ionutms/KiCad_Database_Library/3D_models/CUI_DEVICES_TBP04R2-500-10BE.step

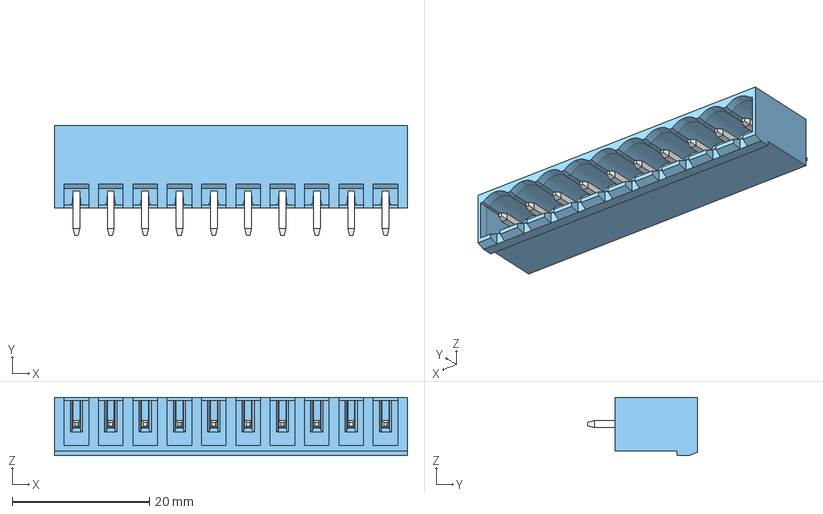
[picture p3: CAD file, 2024-11-04]
3D_models/CUI_DEVICES_TBP04R2-500-10BE.step
51.4 x 16.0 x 8.50 mm
