ionutms/KiCad_Database_Library/3D_models/CUI_DEVICES_TBP04R2-500-09BE.step

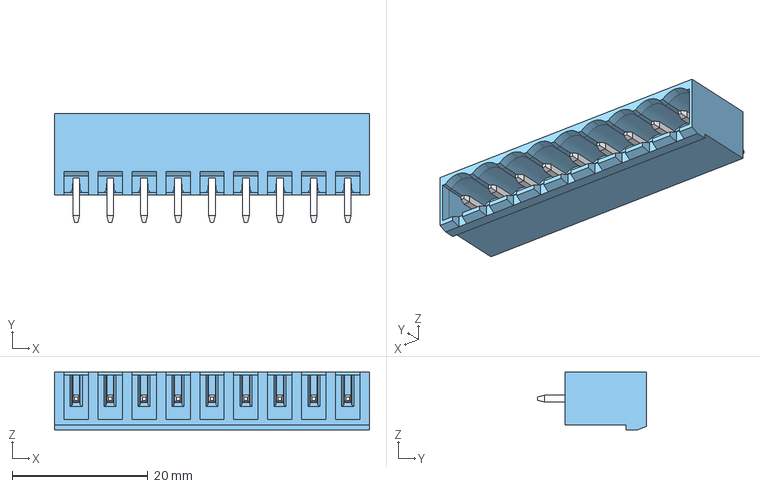
[picture p4: CAD file, 2024-11-04]
3D_models/CUI_DEVICES_TBP04R2-500-09BE.step
46.4 x 16.0 x 8.50 mm
