ionutms/KiCad_Database_Library/3D_models/CUI_DEVICES_TBP04R2-500-03BE.step

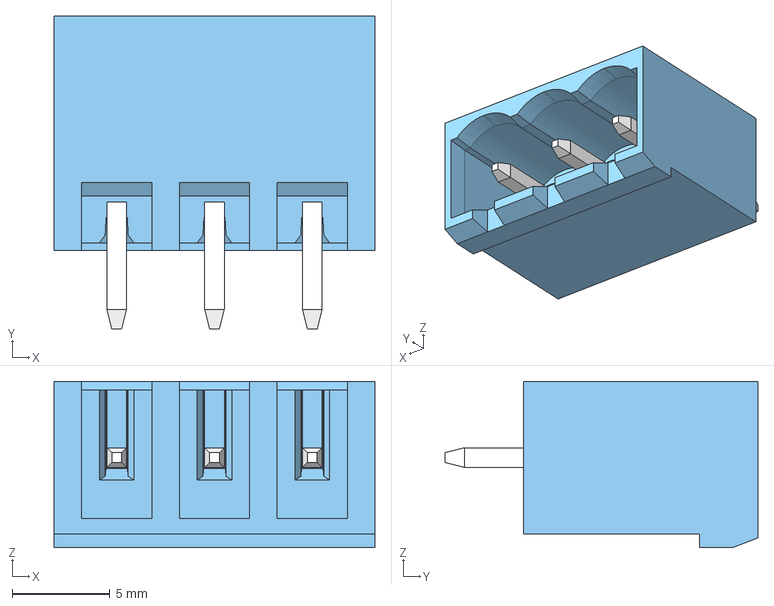
[picture p10: CAD file, 2024-11-04]
3D_models/CUI_DEVICES_TBP04R2-500-03BE.step
16.4 x 16.0 x 8.50 mm
