ionutms/KiCad_Database_Library/3D_models/CUI_DEVICES_TBP04R2-500-02BE.step

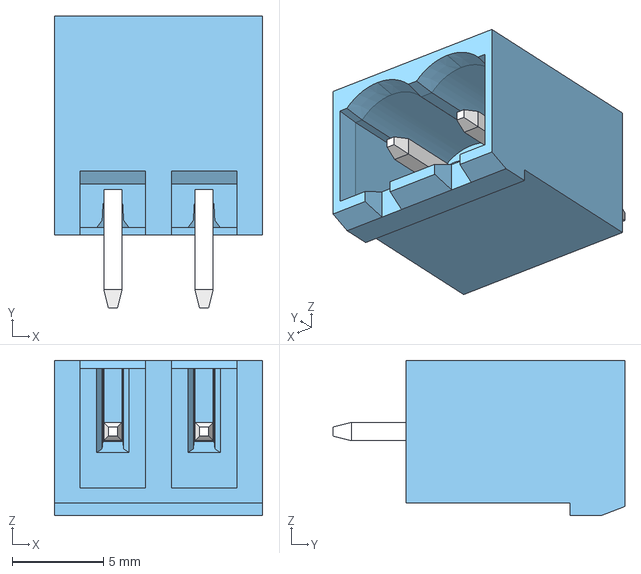
[picture p11: CAD file, 2024-11-04]
3D_models/CUI_DEVICES_TBP04R2-500-02BE.step
11.4 x 16.0 x 8.50 mm
