ionutms/KiCad_Database_Library/3D_models/CUI_DEVICES_TBP02R2-381-14BE.step

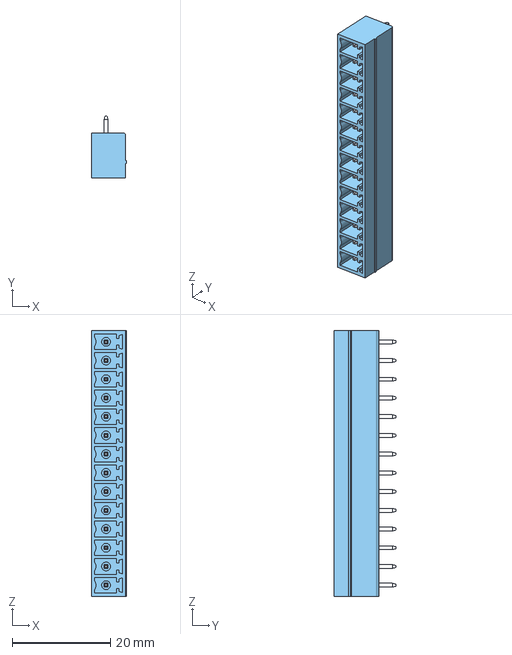
[picture p13: CAD file, 2024-11-04]
3D_models/CUI_DEVICES_TBP02R2-381-14BE.step
7.20 x 12.7 x 54.1 mm
