ionutms/KiCad_Database_Library/3D_models/CUI_DEVICES_TBP02R2-381-12BE.step

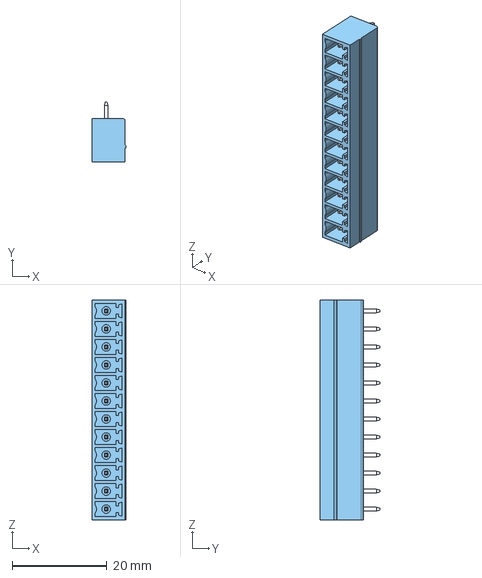
[picture p14: CAD file, 2024-11-04]
3D_models/CUI_DEVICES_TBP02R2-381-12BE.step
7.20 x 12.7 x 46.5 mm
