ionutms/KiCad_Database_Library/3D_models/CUI_DEVICES_TBP02R2-381-10BE.step

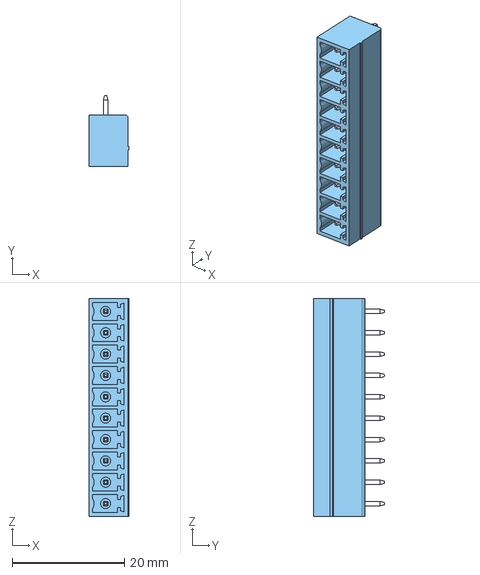
[picture p15: CAD file, 2024-11-04]
3D_models/CUI_DEVICES_TBP02R2-381-10BE.step
7.20 x 12.7 x 38.9 mm
