ionutms/KiCad_Database_Library/3D_models/CUI_DEVICES_TBP02R2-381-07BE.step

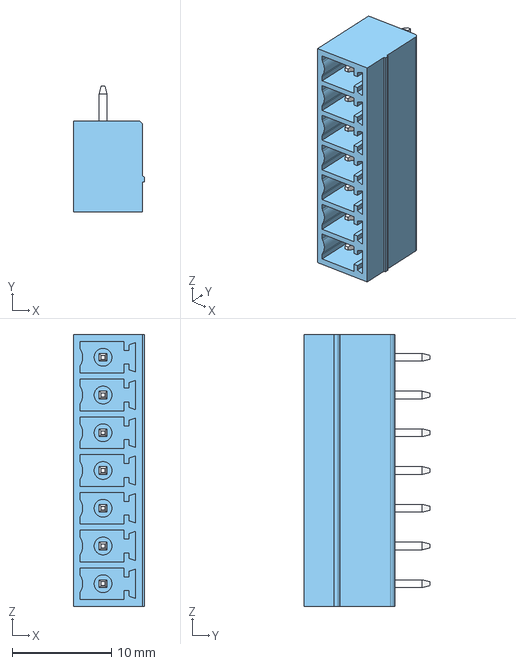
[picture p17: CAD file, 2024-11-03]
3D_models/CUI_DEVICES_TBP02R2-381-07BE.step
7.20 x 12.7 x 27.5 mm
