ionutms/KiCad_Database_Library/3D_models/CUI_DEVICES_TBP02R2-381-06BE.step

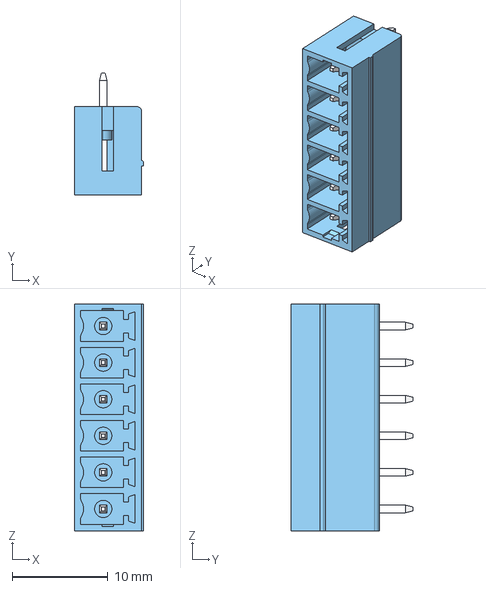
[picture p18: CAD file, 2024-11-03]
3D_models/CUI_DEVICES_TBP02R2-381-06BE.step
7.20 x 12.7 x 23.7 mm
