ionutms/KiCad_Database_Library/3D_models/CUI_DEVICES_TBP02R2-381-05BE.step

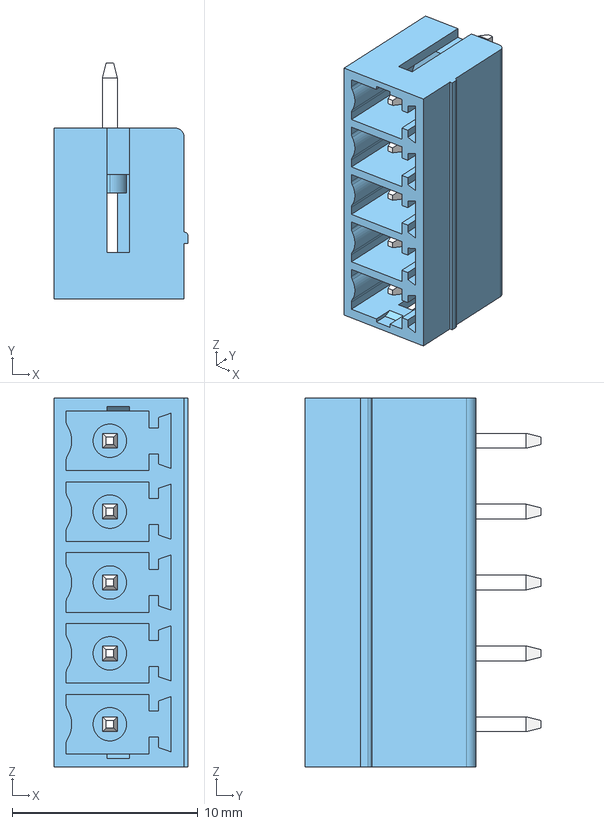
[picture p19: CAD file, 2024-11-03]
3D_models/CUI_DEVICES_TBP02R2-381-05BE.step
7.20 x 12.7 x 19.8 mm
