ionutms/KiCad_Database_Library/3D_models/CUI_DEVICES_TBP02R2-381-04BE.step

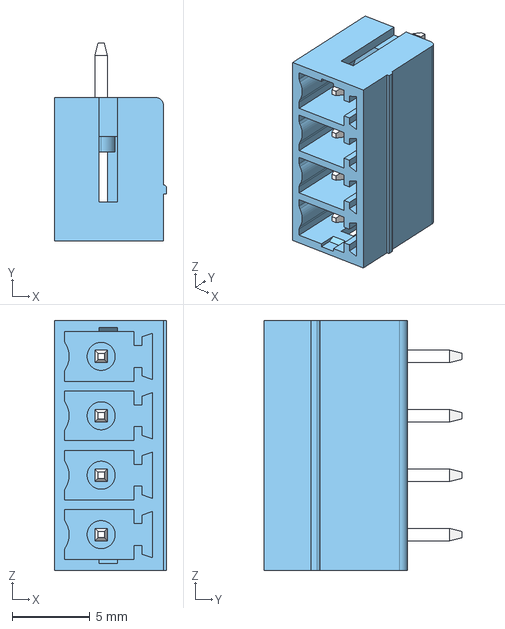
[picture p20: CAD file, 2024-11-03]
3D_models/CUI_DEVICES_TBP02R2-381-04BE.step
7.20 x 12.7 x 16.0 mm
