ionutms/KiCad_Database_Library/3D_models/XAL1580.step

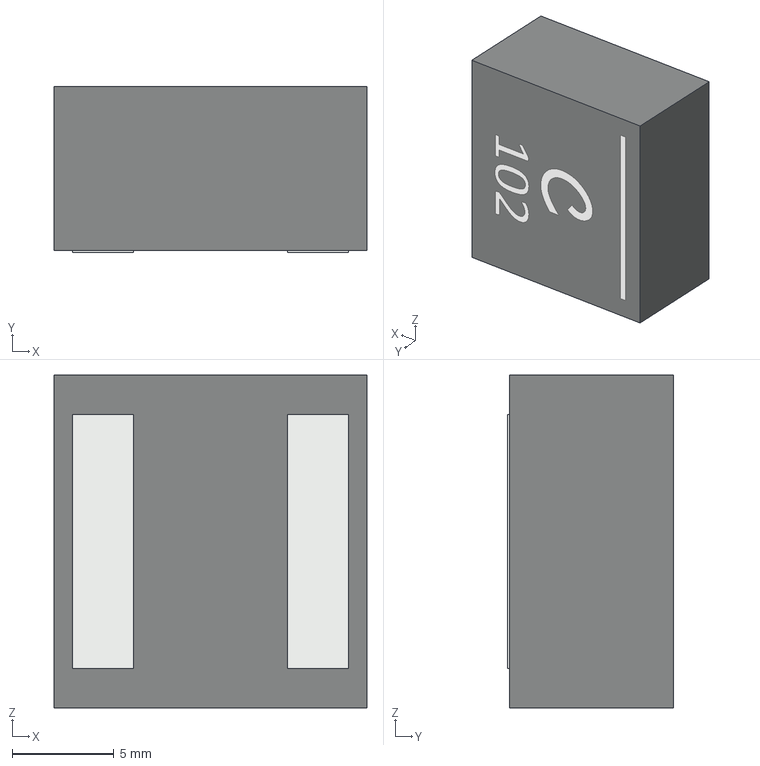
[picture p21: CAD file, 2024-11-01]
3D_models/XAL1580.step
15.4 x 8.20 x 16.4 mm
