ionutms/KiCad_Database_Library/3D_models/XAL1513.step

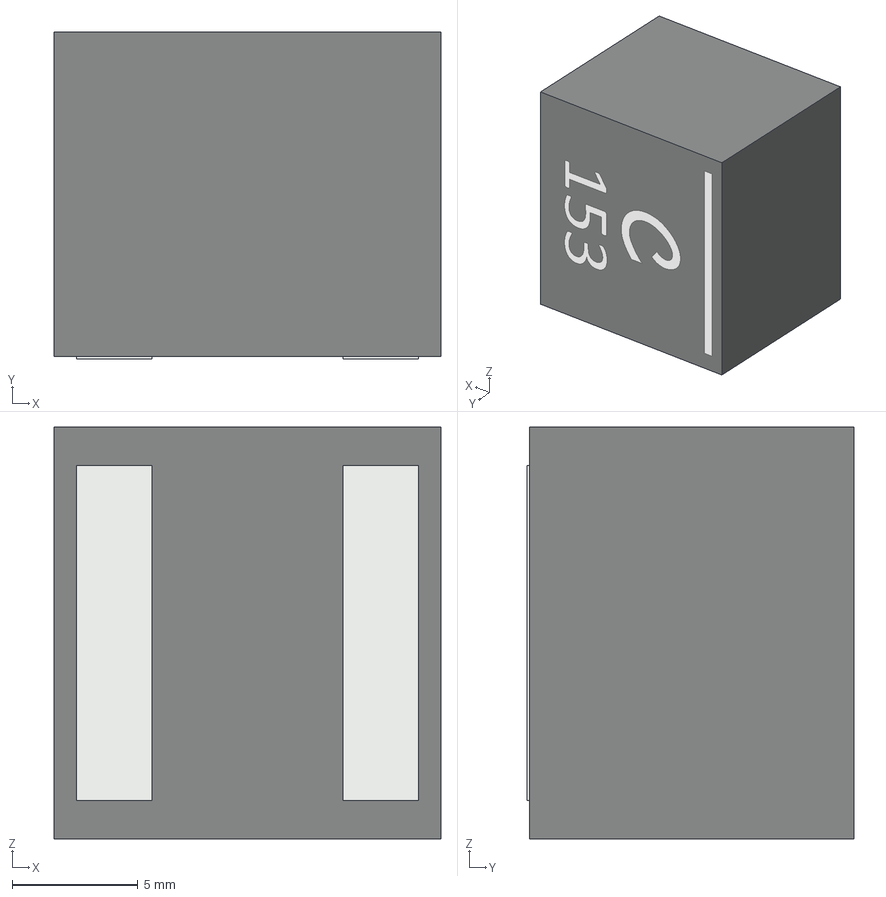
[picture p22: CAD file, 2024-11-01]
3D_models/XAL1513.step
15.4 x 13.0 x 16.4 mm
