ionutms/KiCad_Database_Library/3D_models/XAL1510.step

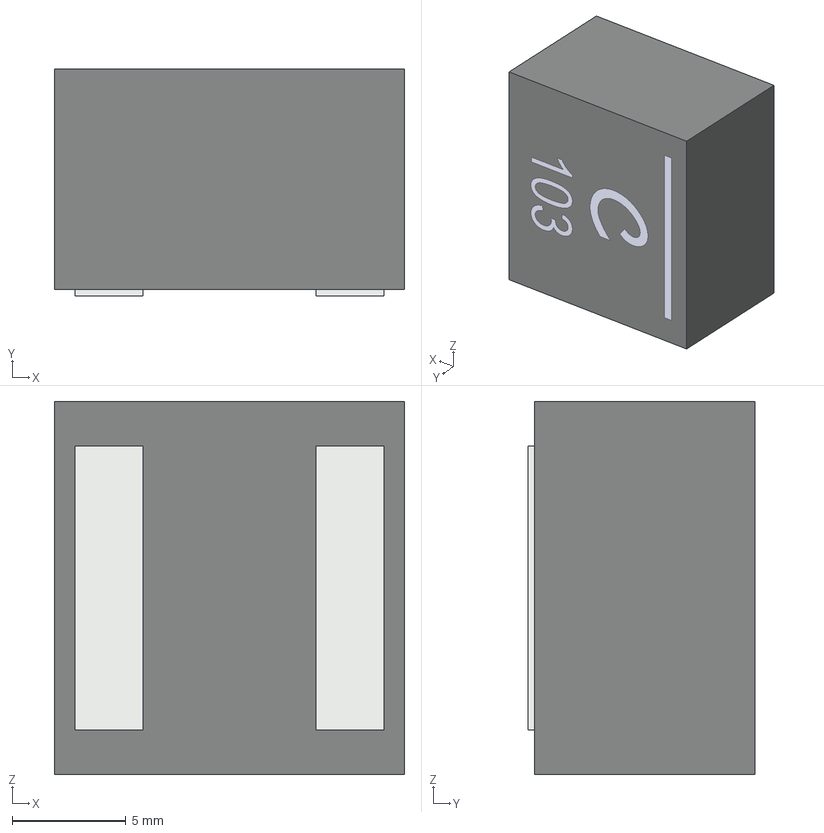
[picture p23: CAD file, 2024-11-01]
3D_models/XAL1510.step
15.4 x 10.0 x 16.4 mm
