ionutms/KiCad_Database_Library/3D_models/XAL1350.step

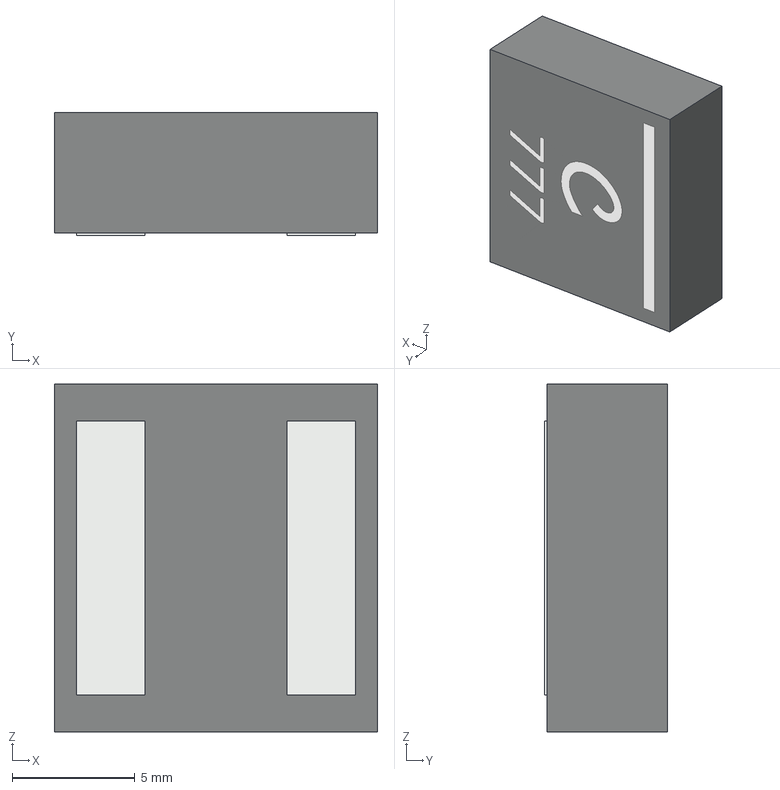
[picture p24: CAD file, 2024-11-01]
3D_models/XAL1350.step
13.2 x 5.00 x 14.2 mm
