ionutms/KiCad_Database_Library/3D_models/XAL1010.step

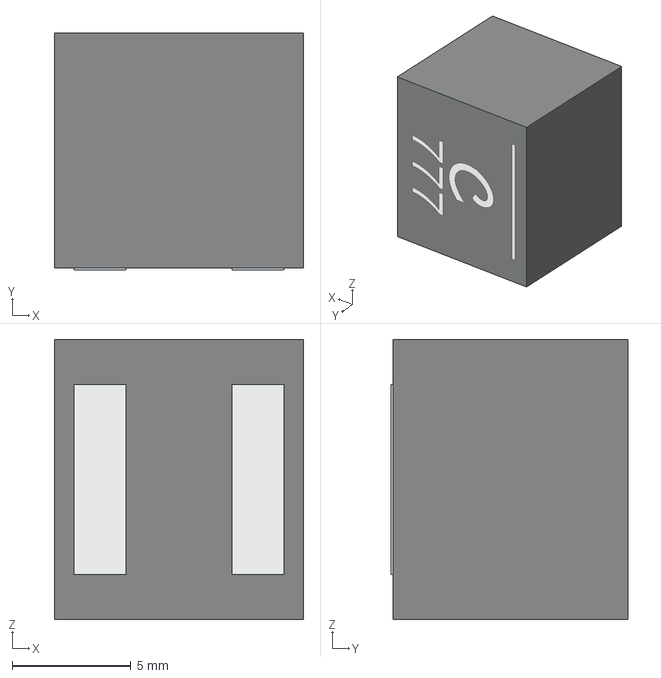
[picture p25: CAD file, 2024-11-01]
3D_models/XAL1010.step
10.5 x 10.0 x 11.8 mm
