ionutms/KiCad_Database_Library/3D_models/XAL8080.step

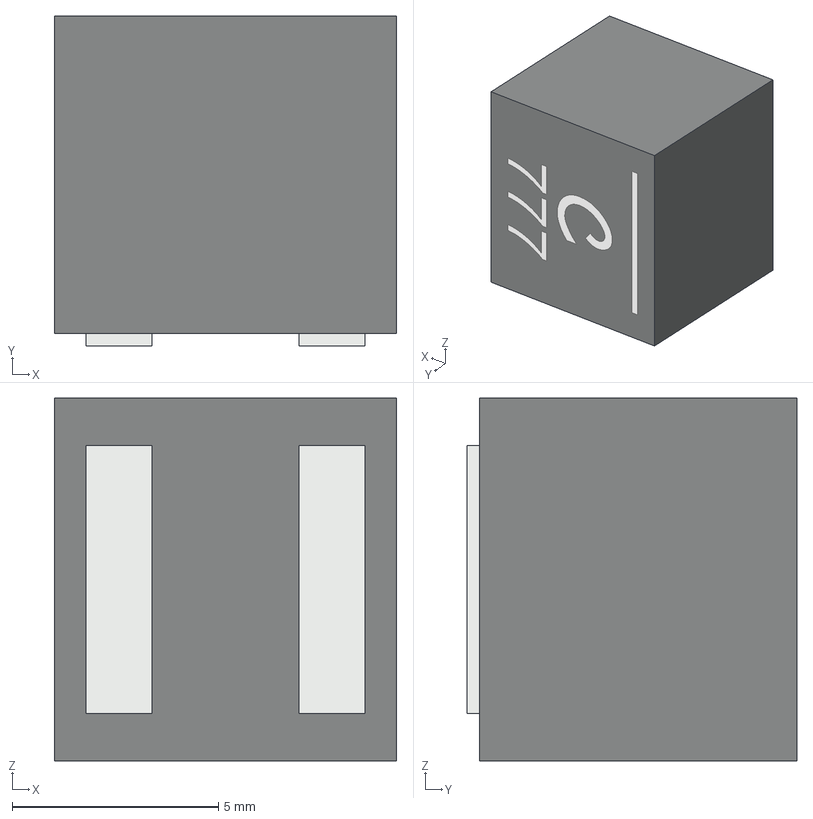
[picture p26: CAD file, 2024-10-31]
3D_models/XAL8080.step
8.30 x 8.00 x 8.80 mm
