ionutms/KiCad_Database_Library/3D_models/XAL8050.step

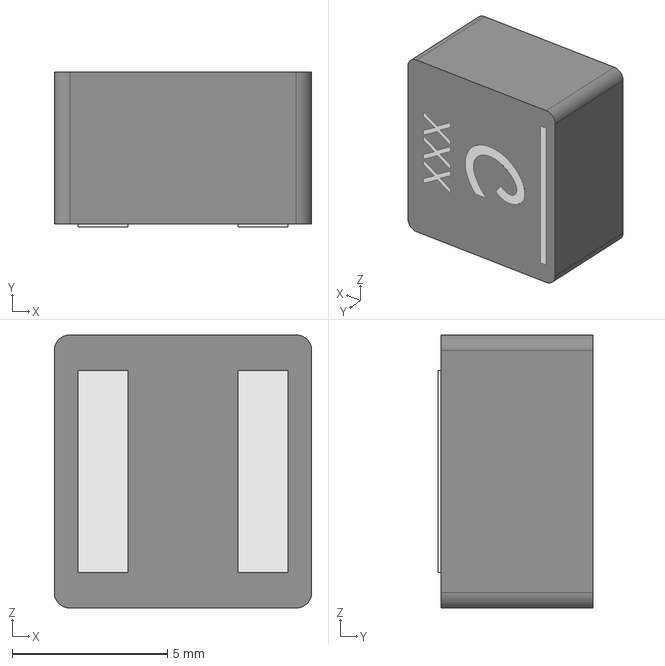
[picture p27: CAD file, 2024-10-31]
3D_models/XAL8050.step
8.30 x 5.00 x 8.80 mm
