ionutms/KiCad_Database_Library/3D_models/XAL7070.step

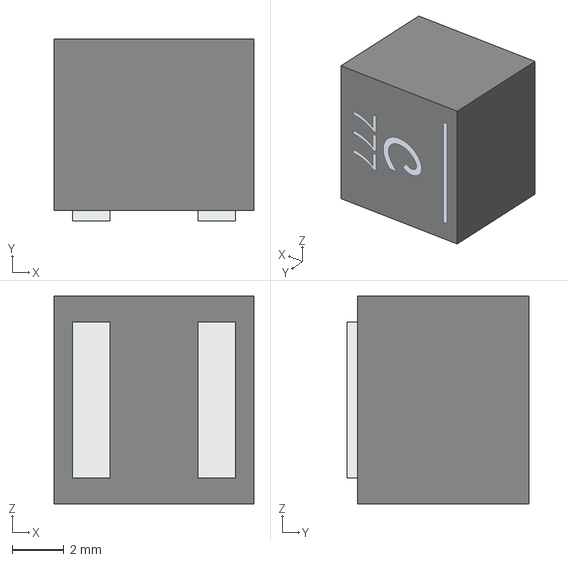
[picture p28: CAD file, 2024-10-31]
3D_models/XAL7070.step
7.70 x 7.00 x 8.00 mm
