ionutms/KiCad_Database_Library/3D_models/XAL7050.step

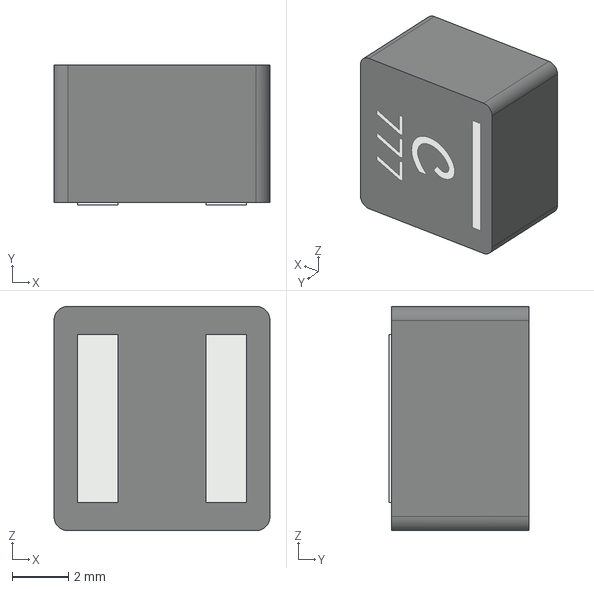
[picture p29: CAD file, 2024-10-31]
3D_models/XAL7050.step
7.70 x 5.00 x 8.00 mm
