ionutms/KiCad_Database_Library/3D_models/XAL7030.step

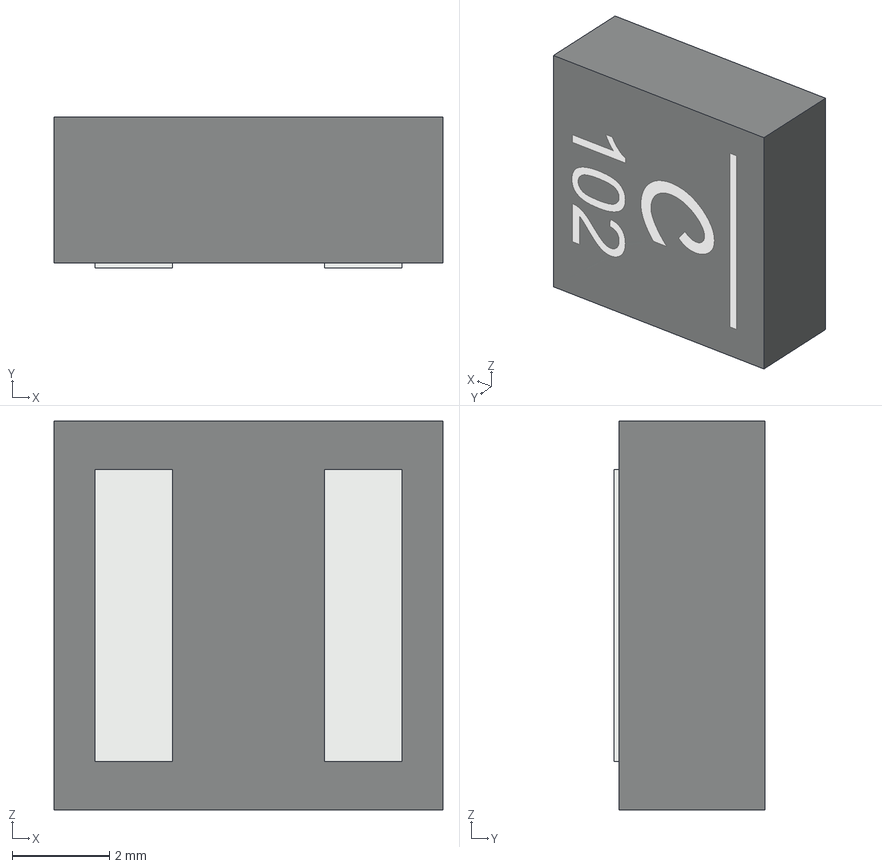
[picture p30: CAD file, 2024-10-31]
3D_models/XAL7030.step
8.00 x 3.10 x 8.00 mm
