ionutms/KiCad_Database_Library/3D_models/XAL1080.step

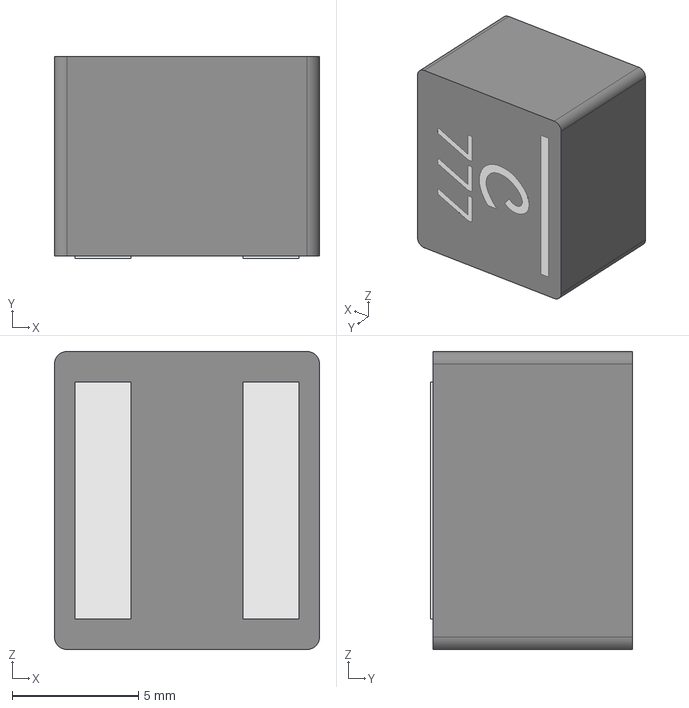
[picture p31: CAD file, 2024-10-31]
3D_models/XAL1080.step
10.5 x 8.00 x 11.8 mm
