ionutms/KiCad_Database_Library/3D_models/XAL1060.step

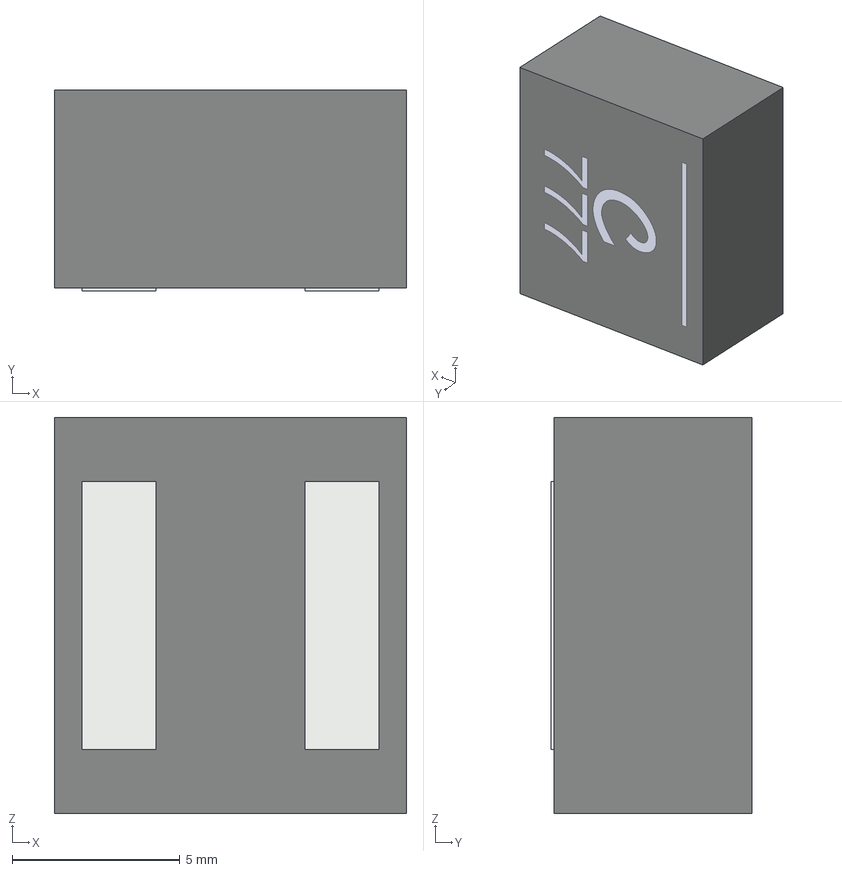
[picture p32: CAD file, 2024-10-31]
3D_models/XAL1060.step
10.5 x 6.00 x 11.8 mm
