ionutms/KiCad_Database_Library/3D_models/XAL1030.step

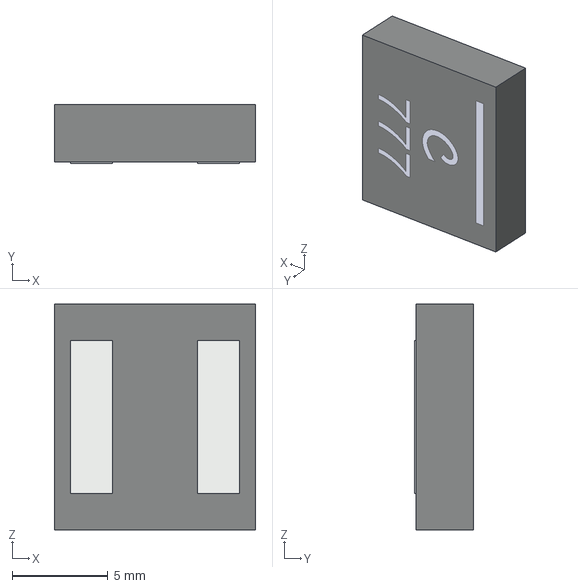
[picture p33: CAD file, 2024-10-31]
3D_models/XAL1030.step
10.5 x 3.10 x 11.8 mm
