ionutms/KiCad_Database_Library/3D_models/XAL7020.step

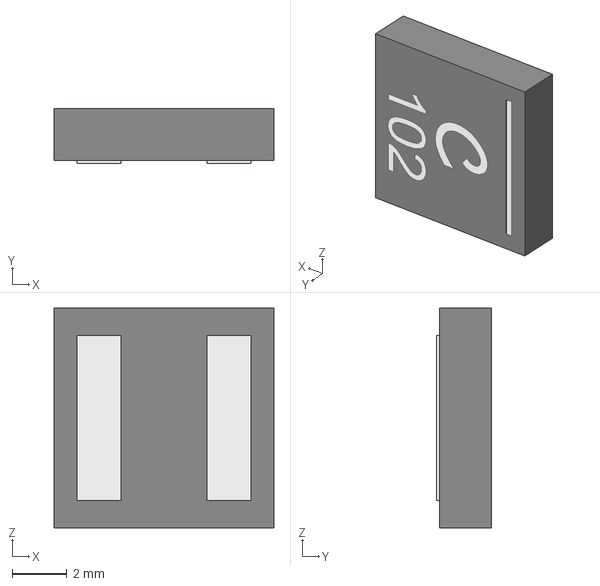
[picture p34: CAD file, 2024-10-30]
3D_models/XAL7020.step
8.00 x 2.00 x 8.00 mm
