ionutms/KiCad_Database_Library/3D_models/XAL6060.step

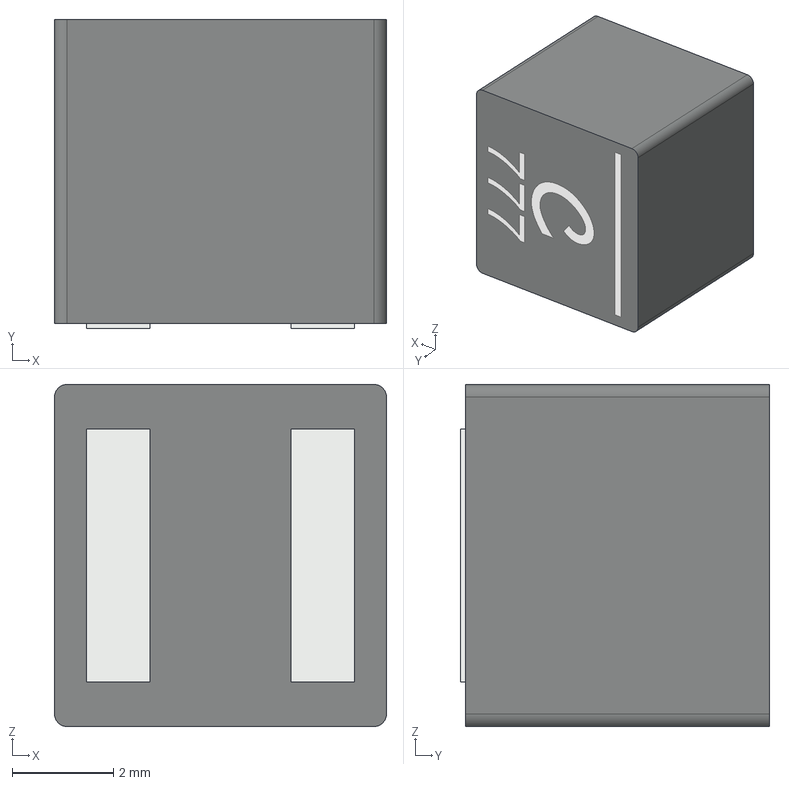
[picture p35: CAD file, 2024-10-30]
3D_models/XAL6060.step
6.56 x 6.10 x 6.76 mm
