ionutms/KiCad_Database_Library/3D_models/XAL6030.step

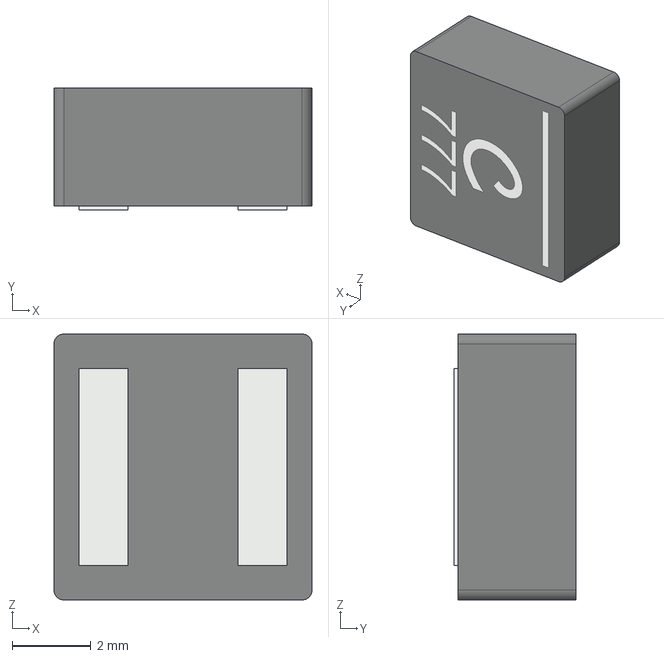
[picture p36: CAD file, 2024-10-30]
3D_models/XAL6030.step
6.56 x 3.10 x 6.76 mm
