ionutms/KiCad_Database_Library/3D_models/XAL6020.step

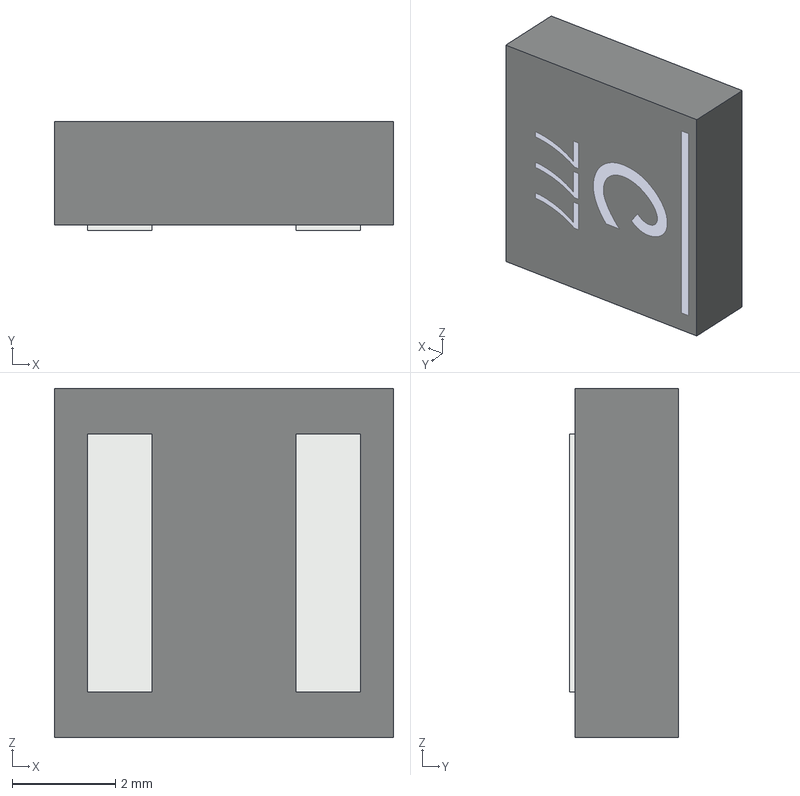
[picture p37: CAD file, 2024-10-30]
3D_models/XAL6020.step
6.56 x 2.10 x 6.76 mm
