ionutms/KiCad_Database_Library/3D_models/XAL5050.step

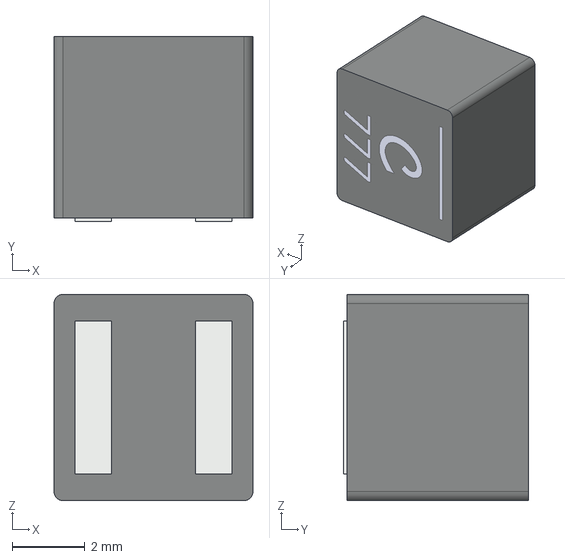
[picture p38: CAD file, 2024-10-30]
3D_models/XAL5050.step
5.48 x 5.10 x 5.68 mm
