ionutms/KiCad_Database_Library/3D_models/XAL5030.step

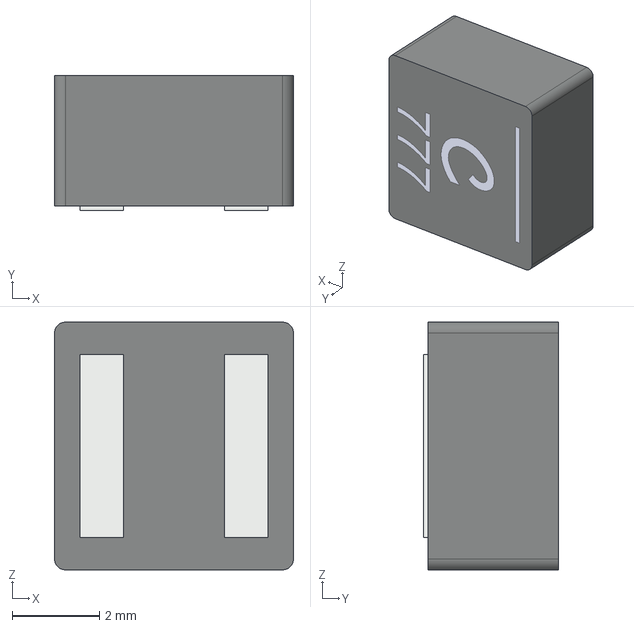
[picture p39: CAD file, 2024-10-30]
3D_models/XAL5030.step
5.48 x 3.10 x 5.68 mm
