ionutms/KiCad_Database_Library/3D_models/XAL5020.step

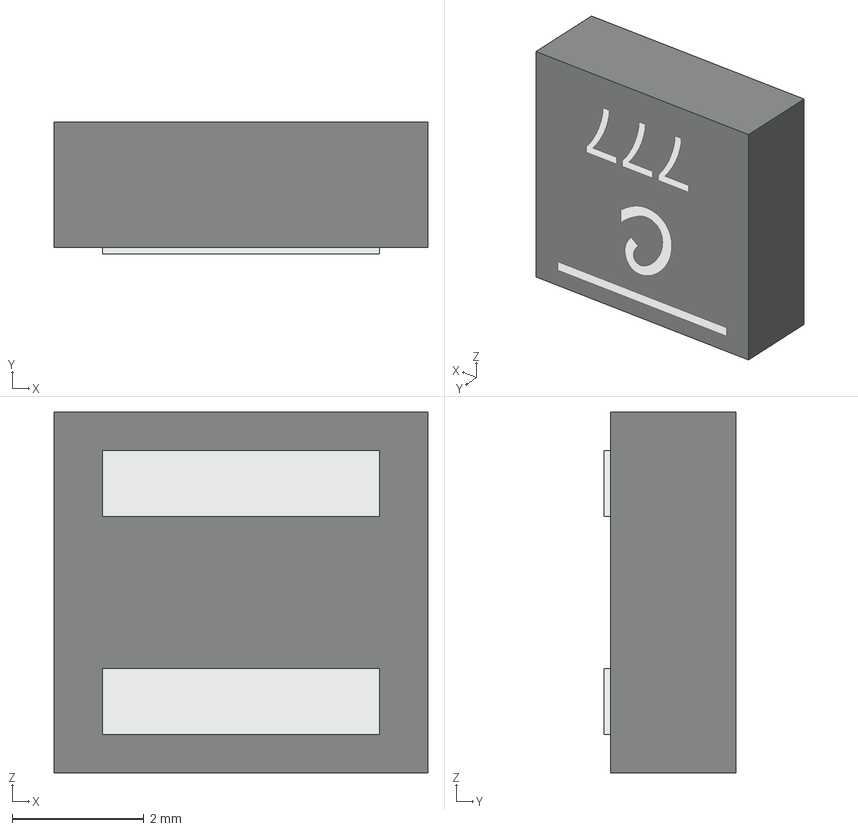
[picture p40: CAD file, 2024-10-30]
3D_models/XAL5020.step
5.68 x 2.00 x 5.48 mm
