ionutms/KiCad_Database_Library/3D_models/XAL4040.step

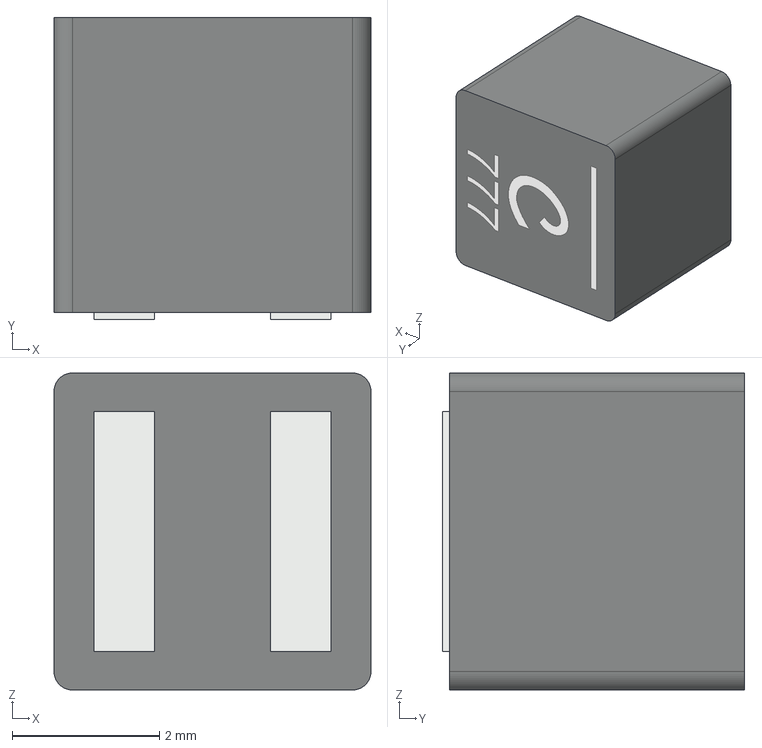
[picture p41: CAD file, 2024-10-30]
3D_models/XAL4040.step
4.30 x 4.10 x 4.30 mm
