ionutms/KiCad_Database_Library/3D_models/XAL4030.step

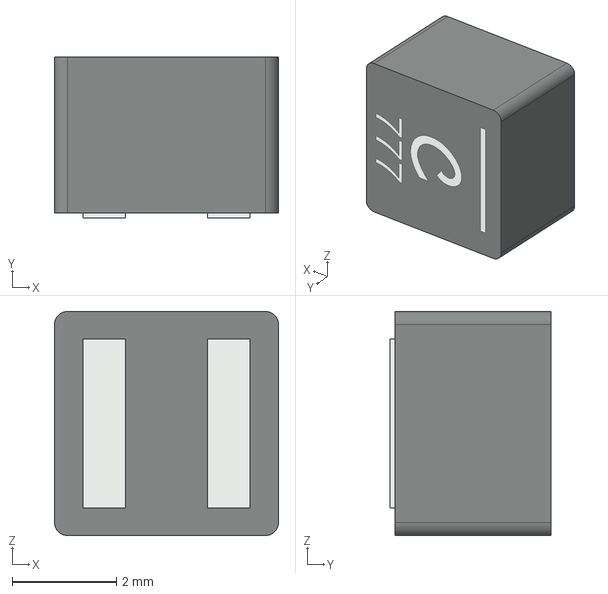
[picture p42: CAD file, 2024-10-30]
3D_models/XAL4030.step
4.30 x 3.10 x 4.30 mm
