ionutms/KiCad_Database_Library/3D_models/XAL4020.step

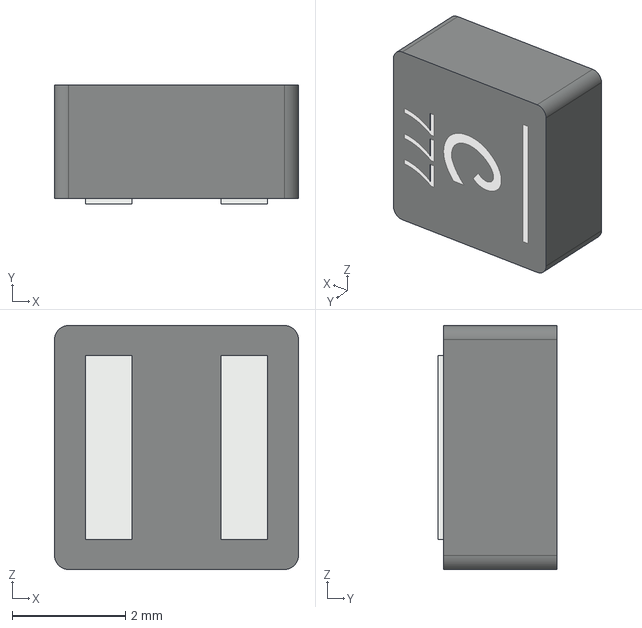
[picture p43: CAD file, 2024-10-30]
3D_models/XAL4020.step
4.30 x 2.10 x 4.30 mm
