ionutms/KiCad_Database_Library/3D_models/XFL2005.step

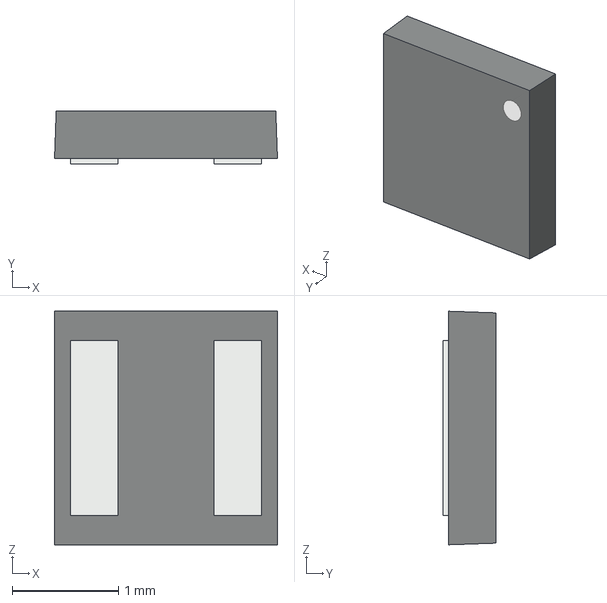
[picture p44: CAD file, 2024-10-30]
3D_models/XFL2005.step
2.10 x 0.5 x 2.20 mm
