ionutms/KiCad_Database_Library/3D_models/XFL2006.step

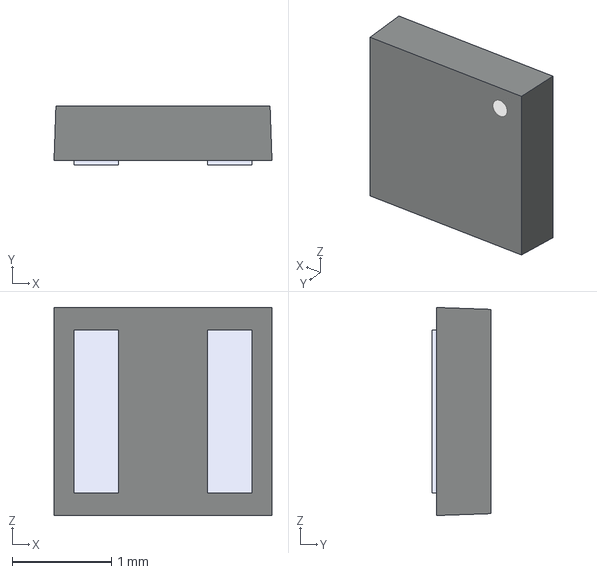
[picture p45: CAD file, 2024-10-30]
3D_models/XFL2006.step
2.20 x 0.6 x 2.10 mm
