ionutms/KiCad_Database_Library/3D_models/XFL2010.step

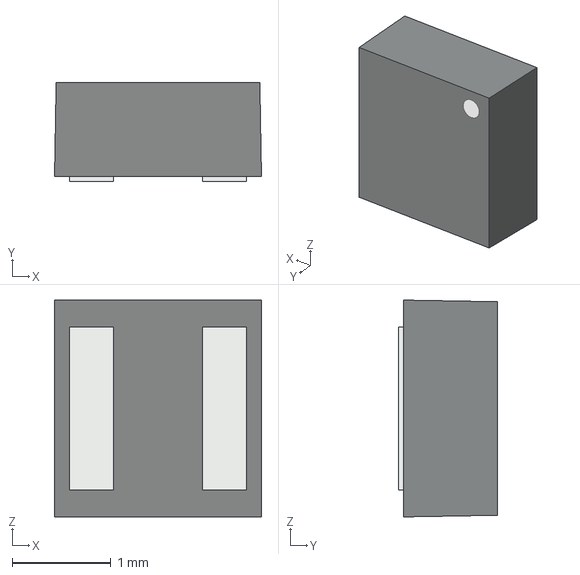
[picture p46: CAD file, 2024-10-30]
3D_models/XFL2010.step
2.10 x 1.00 x 2.20 mm
