ionutms/KiCad_Database_Library/3D_models/XFL7015.step

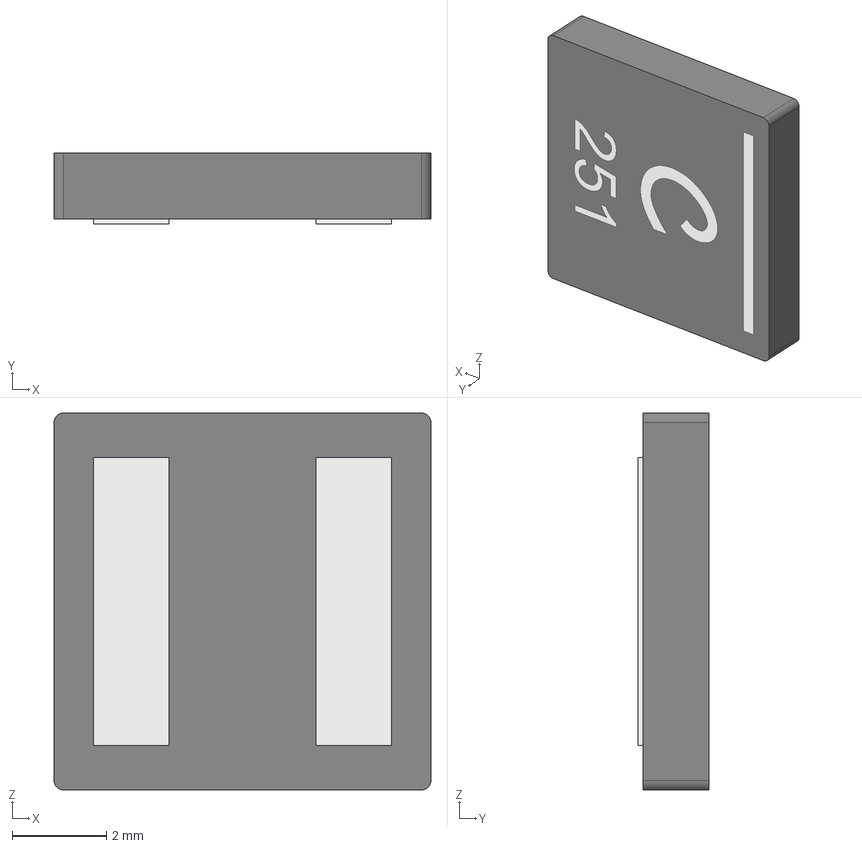
[picture p47: CAD file, 2024-10-28]
3D_models/XFL7015.step
8.00 x 1.50 x 8.00 mm
