ionutms/KiCad_Database_Library/3D_models/XFL6012.step

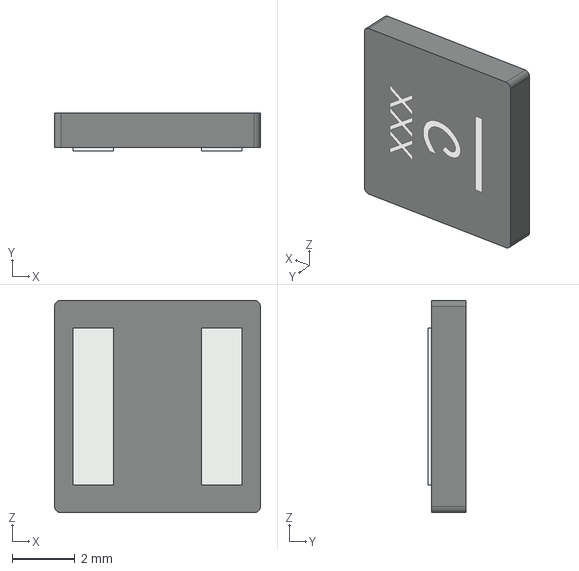
[picture p48: CAD file, 2024-10-28]
3D_models/XFL6012.step
6.56 x 1.20 x 6.76 mm
