ionutms/KiCad_Database_Library/3D_models/XFL5018.step

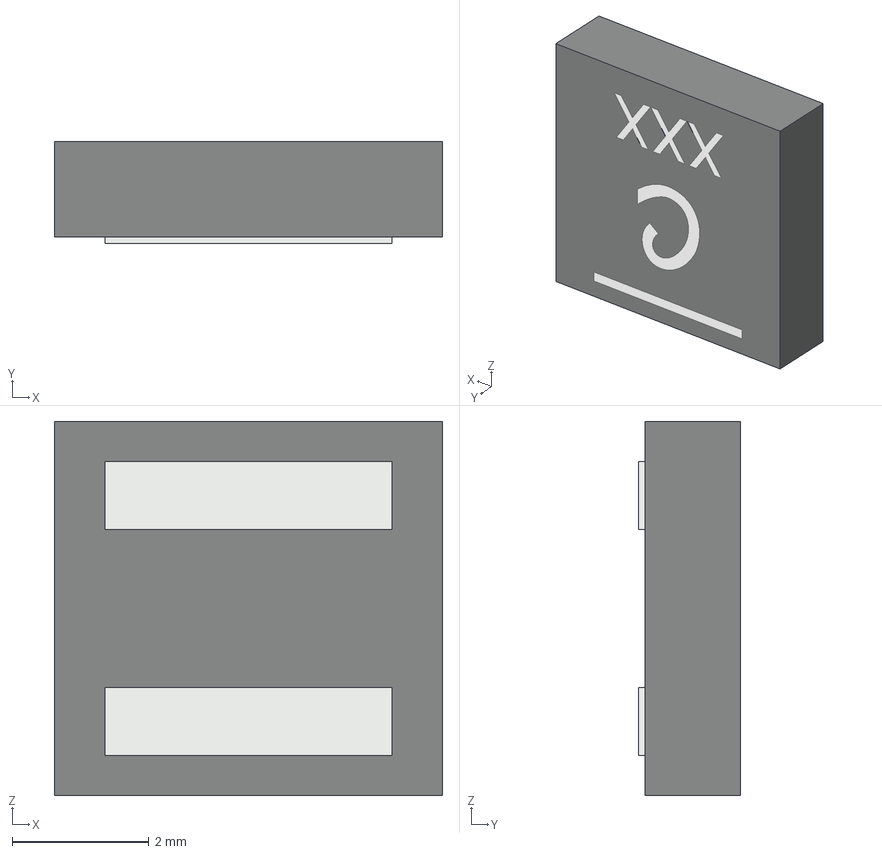
[picture p49: CAD file, 2024-10-28]
3D_models/XFL5018.step
5.68 x 1.50 x 5.48 mm
