ionutms/KiCad_Database_Library/3D_models/XFL4015.step

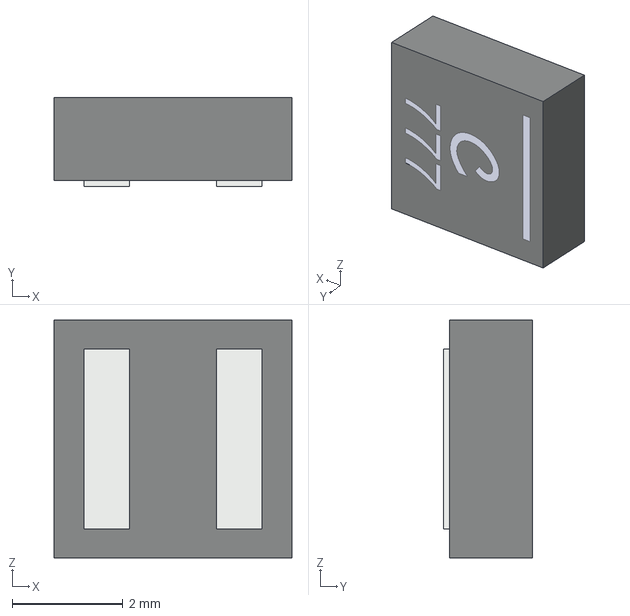
[picture p50: CAD file, 2024-10-28]
3D_models/XFL4015.step
4.30 x 1.60 x 4.30 mm
