ionutms/KiCad_Database_Library/3D_models/XFL4012.step

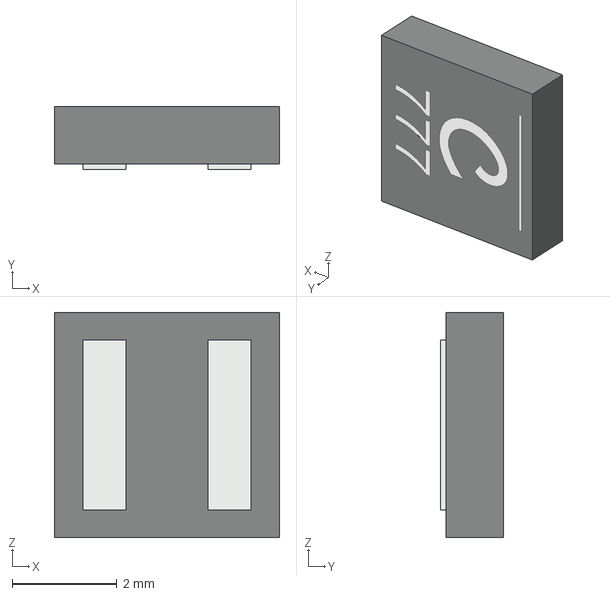
[picture p51: CAD file, 2024-10-28]
3D_models/XFL4012.step
4.30 x 1.20 x 4.30 mm
