ionutms/KiCad_Database_Library/3D_models/XFL3012.step

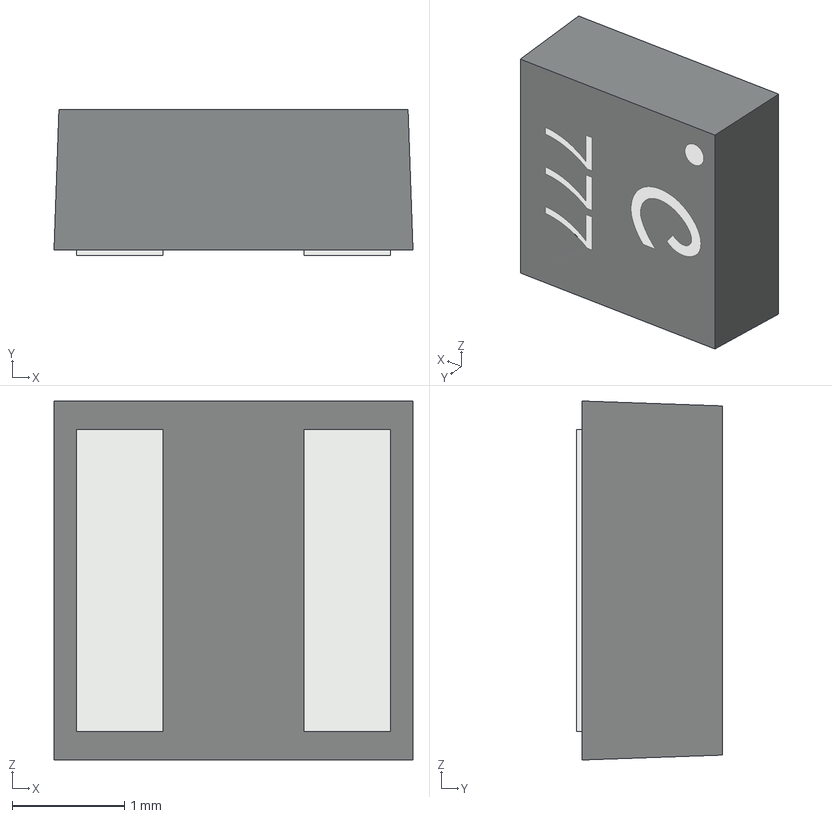
[picture p52: CAD file, 2024-10-28]
3D_models/XFL3012.step
3.20 x 1.30 x 3.20 mm
