ionutms/KiCad_Database_Library/3D_models/XFL3010.step

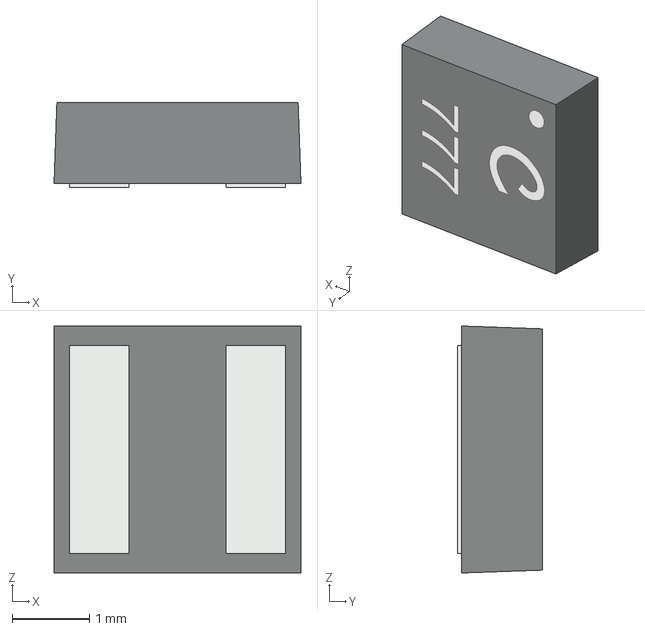
[picture p53: CAD file, 2024-10-28]
3D_models/XFL3010.step
3.20 x 1.10 x 3.20 mm
