ionutms/KiCad_Database_Library/3D_models/R_1206.step

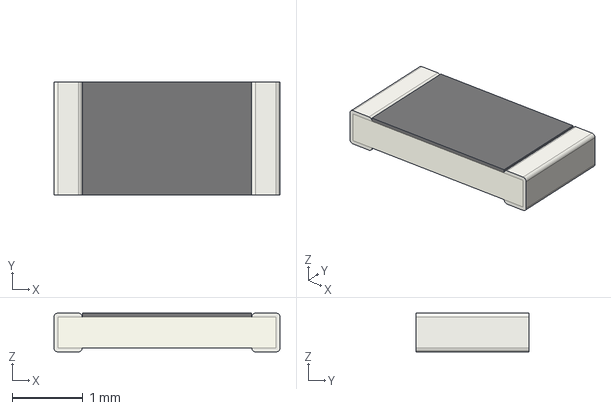
[picture p54: CAD file, 2024-10-23]
3D_models/R_1206.step
3.20 x 1.60 x 0.55 mm
