ionutms/KiCad_Database_Library/3D_models/SMCJ40CA.step

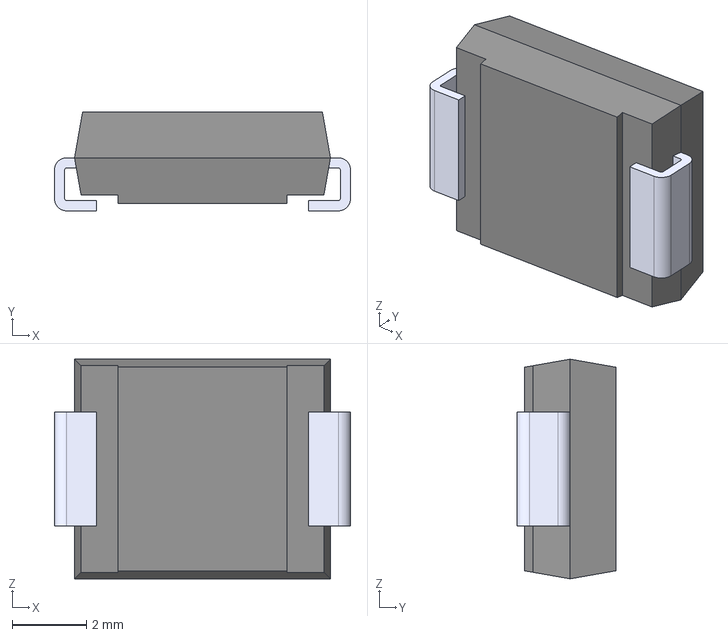
[picture p55: CAD file, 2024-10-07]
3D_models/SMCJ40CA.step
7.95 x 2.65 x 5.90 mm
