ionutms/KiCad_Database_Library/3D_models/SC-70.step

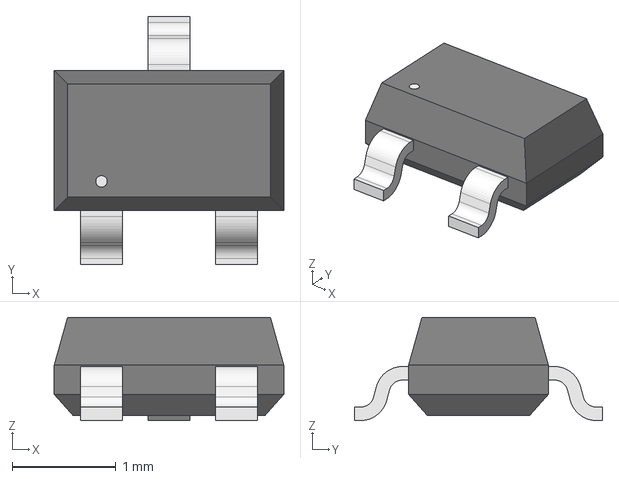
[picture p56: CAD file, 2024-10-05]
3D_models/SC-70.step
2.21 x 2.39 x 0.993 mm
