ionutms/KiCad_Database_Library/3D_models/SOT-26.step

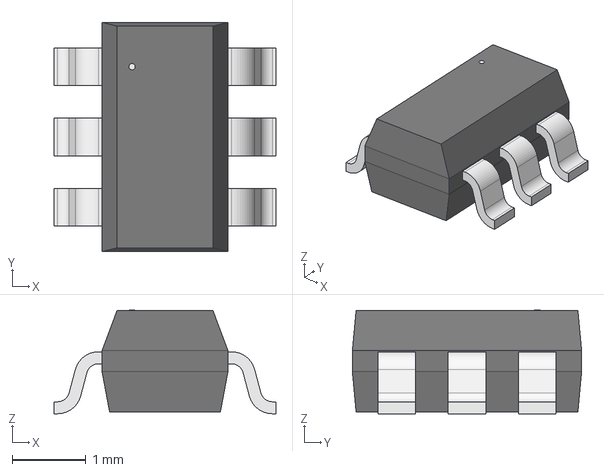
[picture p57: CAD file, 2024-10-05]
3D_models/SOT-26.step
3.00 x 3.10 x 1.40 mm
