ionutms/KiCad_Database_Library/3D_models/L_0402.step

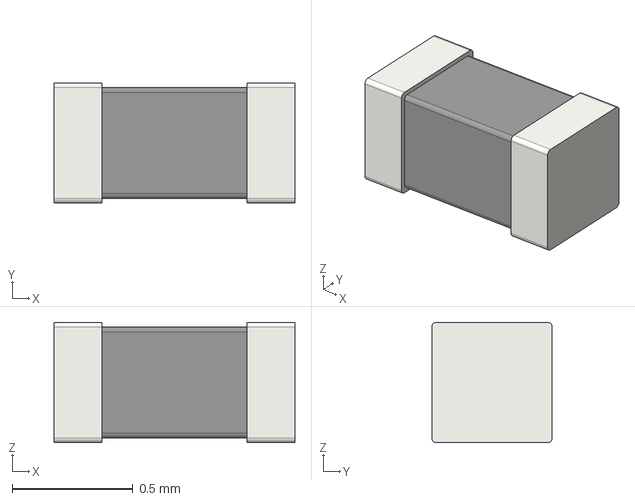
[picture p58: CAD file, 2024-10-05]
3D_models/L_0402.step
1.00 x 0.5 x 0.5 mm
