ionutms/KiCad_Database_Library/3D_models/R_2010.step

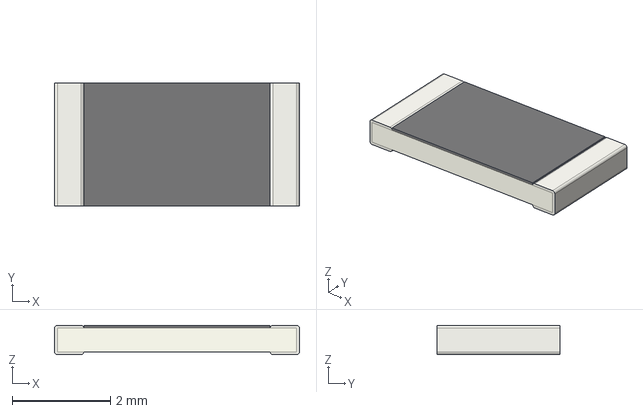
[picture p59: CAD file, 2024-10-05]
3D_models/R_2010.step
5.00 x 2.50 x 0.6 mm
