ionutms/KiCad_Database_Library/3D_models/C_1812.step

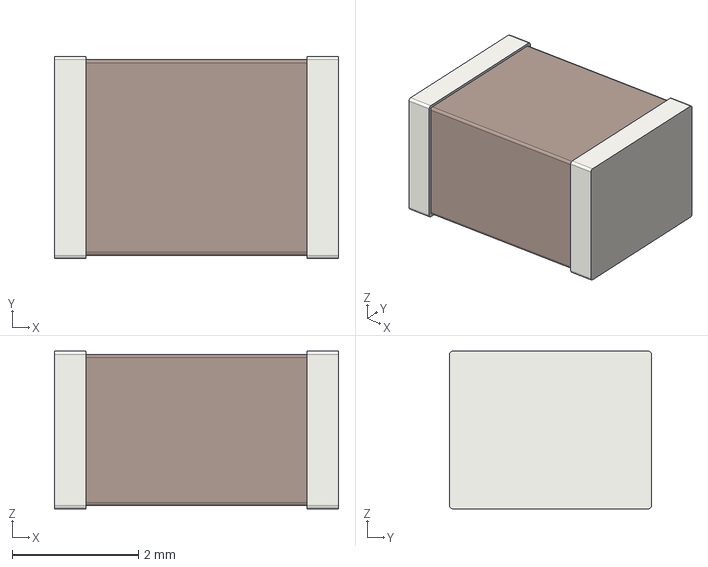
[picture p60: CAD file, 2024-10-05]
3D_models/C_1812.step
4.50 x 3.20 x 2.50 mm
