ionutms/KiCad_Database_Library/3D_models/SOT-323.step

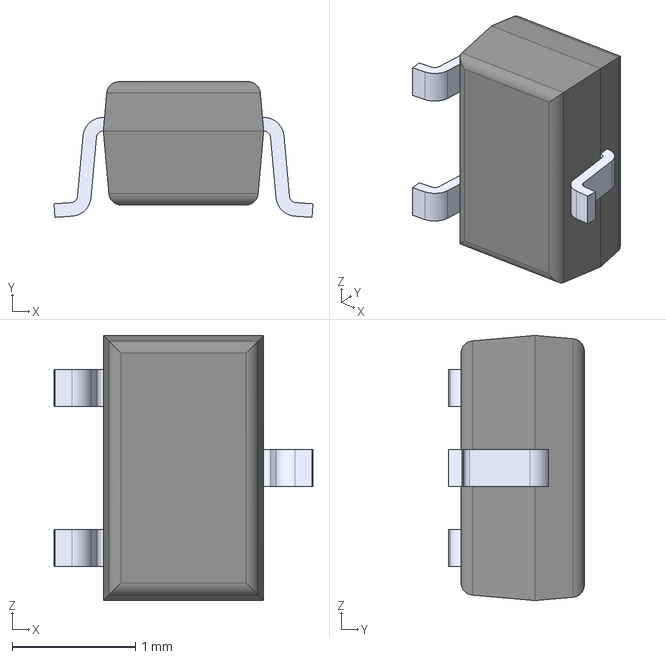
[picture p61: CAD file, 2024-10-04]
3D_models/SOT-323.step
2.10 x 1.10 x 2.15 mm
