ionutms/KiCad_Database_Library/3D_models/SOT1205.step

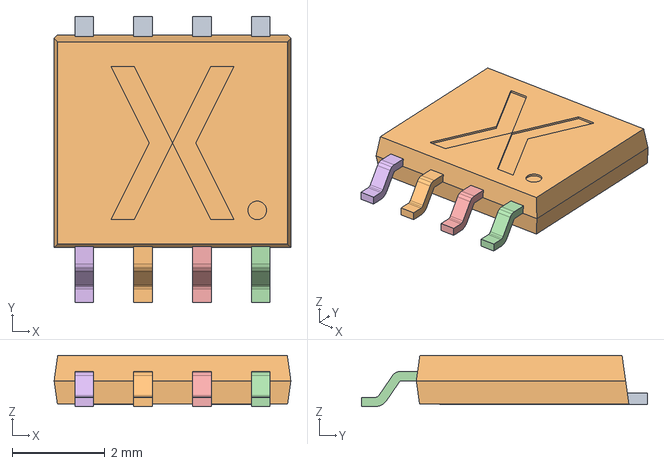
[picture p62: CAD file, 2024-10-04]
3D_models/SOT1205.step
5.10 x 6.16 x 1.10 mm
