ionutms/KiCad_Database_Library/3D_models/R_0805.step

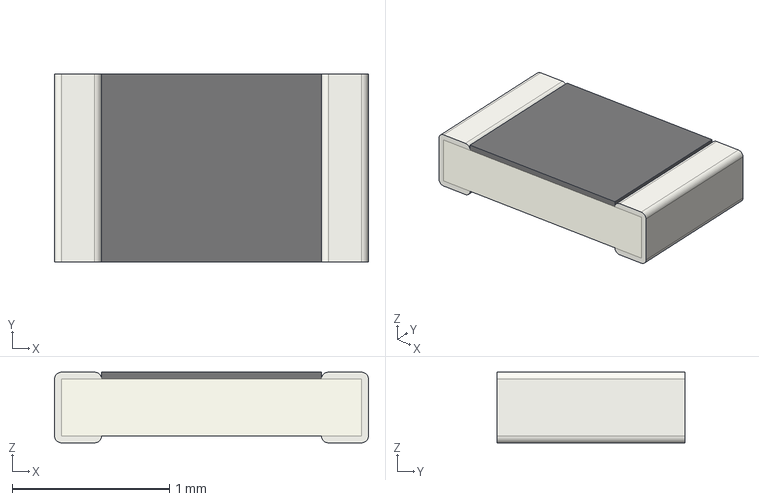
[picture p63: CAD file, 2024-10-04]
3D_models/R_0805.step
2.00 x 1.20 x 0.45 mm
