ionutms/KiCad_Database_Library/3D_models/SOD128.step

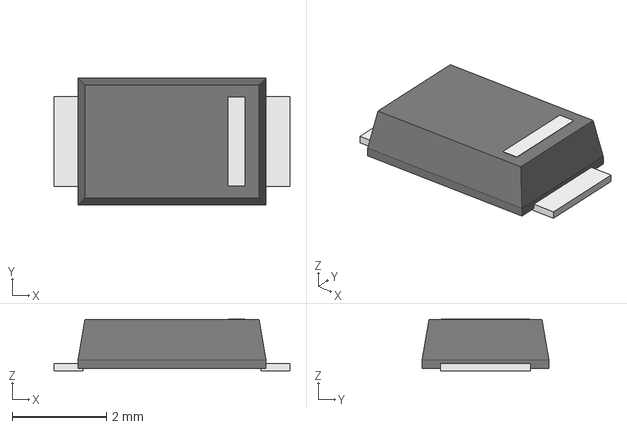
[picture p64: CAD file, 2024-10-04]
3D_models/SOD128.step
5.00 x 2.69 x 1.10 mm
