ionutms/KiCad_Database_Library/3D_models/SOD123W.step

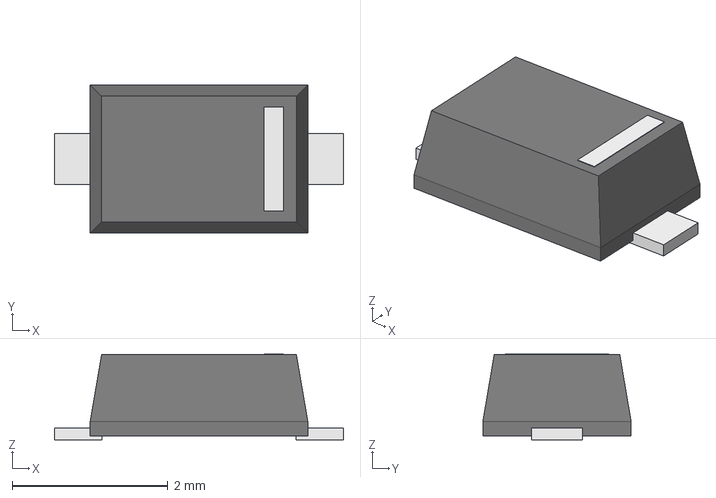
[picture p65: CAD file, 2024-10-04]
3D_models/SOD123W.step
3.71 x 1.90 x 1.10 mm
