ionutms/KiCad_Database_Library/3D_models/MSD1048H.step

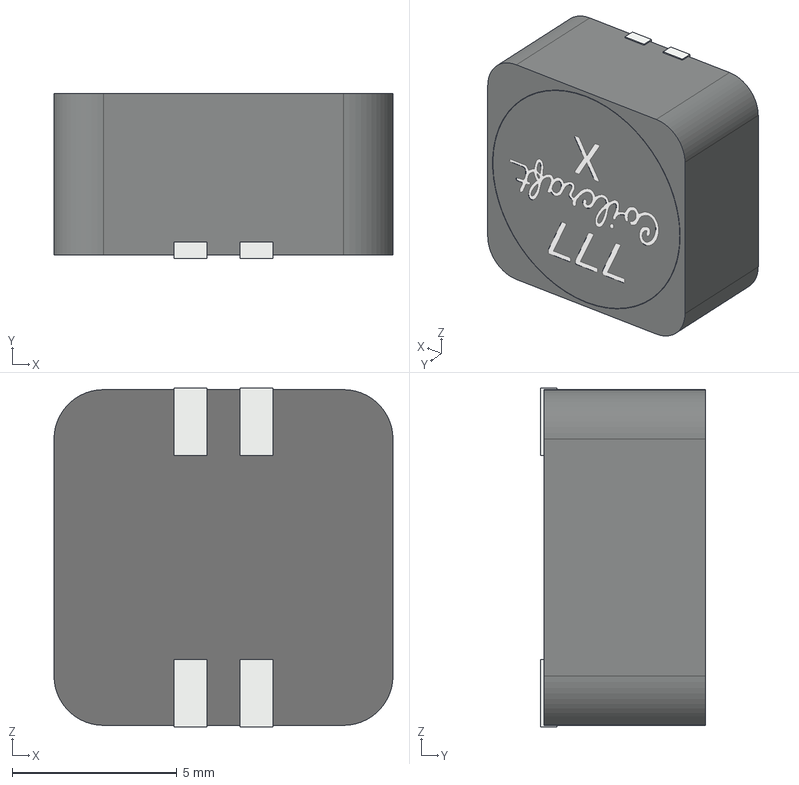
[picture p66: CAD file, 2024-10-04]
3D_models/MSD1048H.step
10.3 x 5.00 x 10.3 mm
