ionutms/KiCad_Database_Library/3D_models/CP_8_10_ADI.step

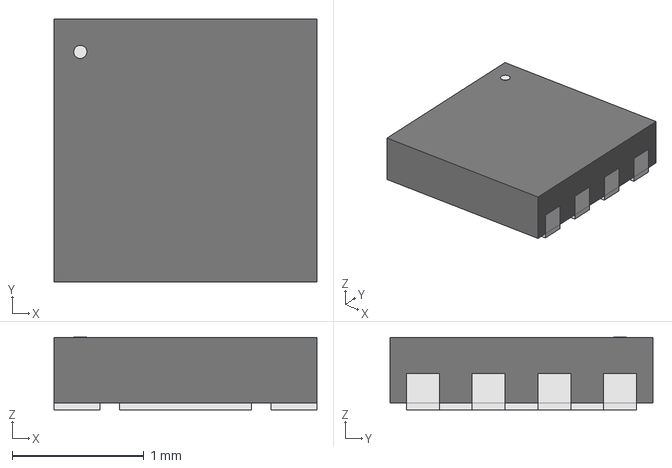
[picture p67: CAD file, 2024-10-03]
3D_models/CP_8_10_ADI.step
2.00 x 2.00 x 0.553 mm
