ionutms/KiCad_Database_Library/3D_models/SRF0905A.step

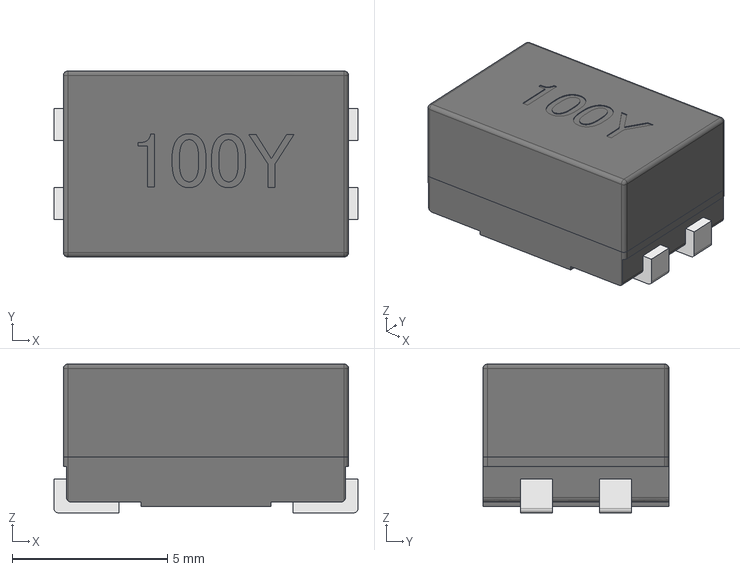
[picture p68: CAD file, 2024-10-03]
3D_models/SRF0905A.step
9.80 x 6.00 x 4.80 mm
