ionutms/KiCad_Database_Library/3D_models/SOD-123.step

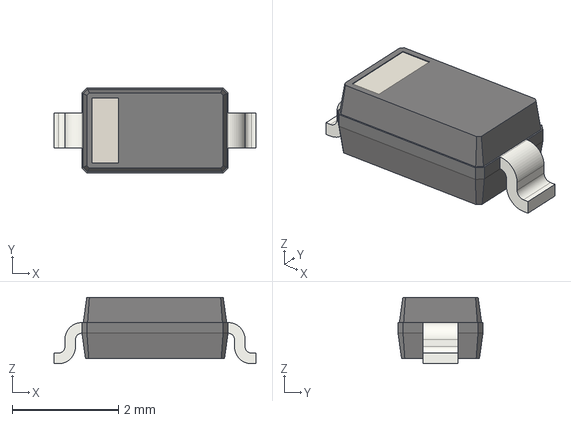
[picture p69: CAD file, 2024-10-02]
3D_models/SOD-123.step
3.80 x 1.60 x 1.25 mm
