ionutms/KiCad_Database_Library/3D_models/PowerDI-123.step

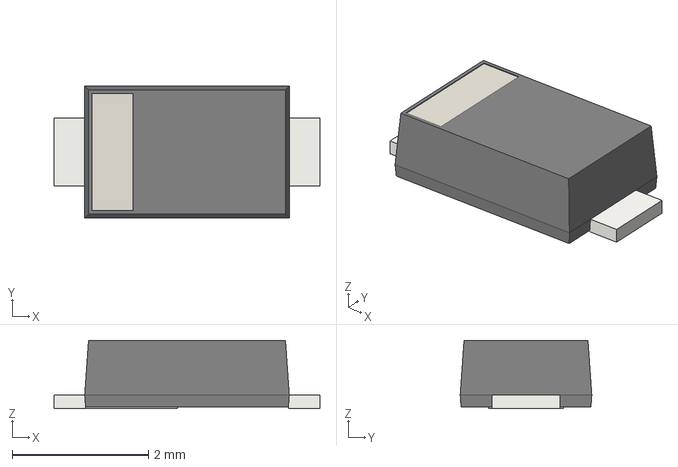
[picture p70: CAD file, 2024-10-02]
3D_models/PowerDI-123.step
3.90 x 1.93 x 1.00 mm
