ionutms/KiCad_Database_Library/3D_models/C_1210.step

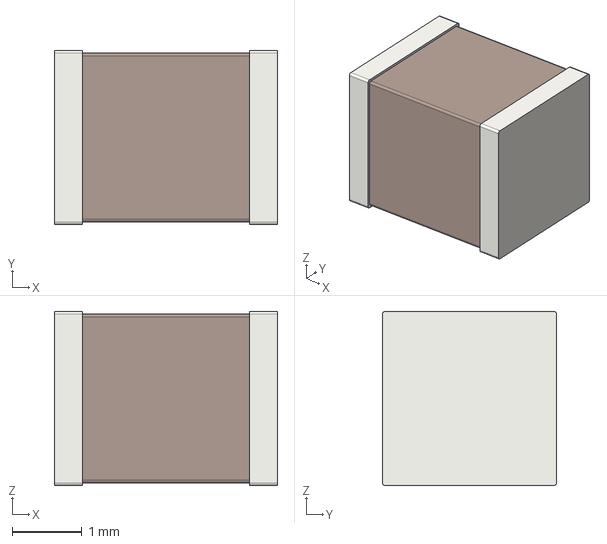
[picture p71: CAD file, 2024-10-02]
3D_models/C_1210.step
3.20 x 2.50 x 2.50 mm
