ionutms/KiCad_Database_Library/3D_models/SOD123F.step

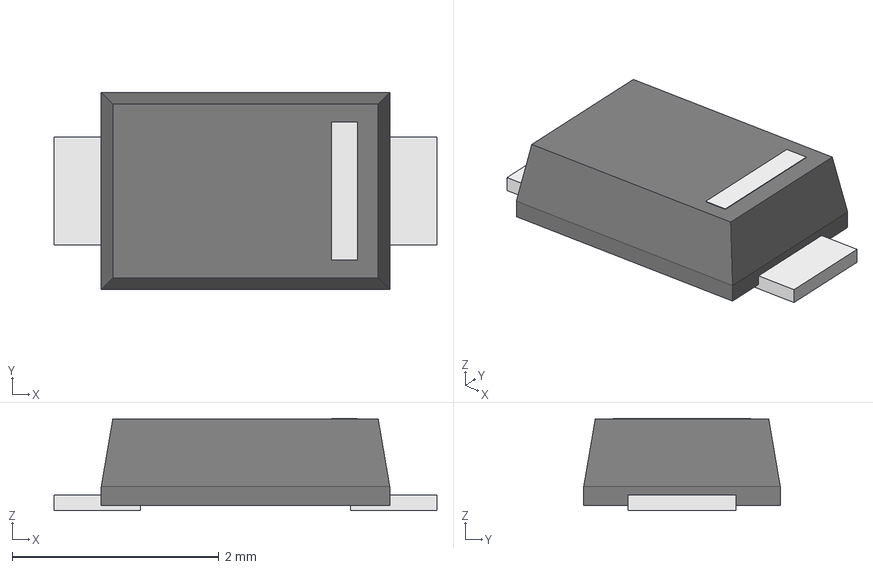
[picture p72: CAD file, 2024-10-02]
3D_models/SOD123F.step
3.71 x 1.90 x 0.895 mm
