ionutms/KiCad_Database_Library/3D_models/ZA9644-AED.step

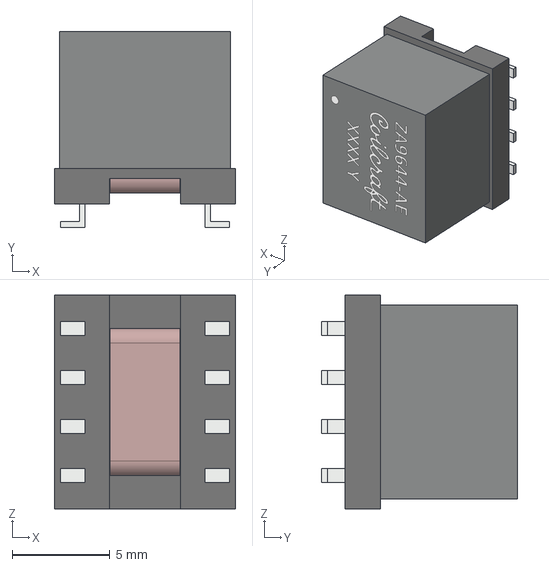
[picture p73: CAD file, 2024-10-02]
3D_models/ZA9644-AED.step
9.25 x 10.0 x 10.9 mm
