ionutms/KiCad_Database_Library/3D_models/SOT1210.step

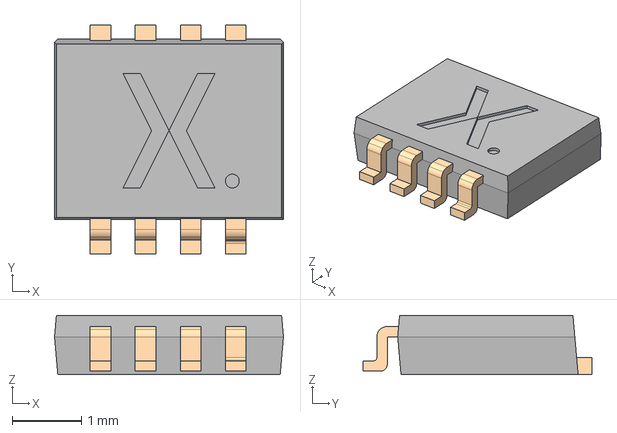
[picture p74: CAD file, 2024-10-02]
3D_models/SOT1210.step
3.30 x 3.30 x 0.855 mm
