ionutms/KiCad_Database_Library/3D_models/PG-BGA-24-801.step

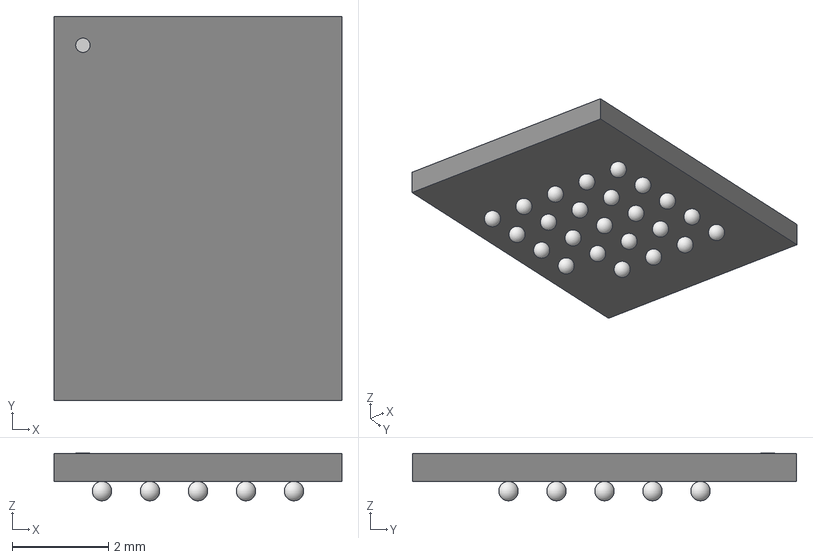
[picture p75: CAD file, 2024-10-02]
3D_models/PG-BGA-24-801.step
5.99 x 8.00 x 0.993 mm
