ionutms/KiCad_Database_Library/3D_models/BSS138-7-F.step

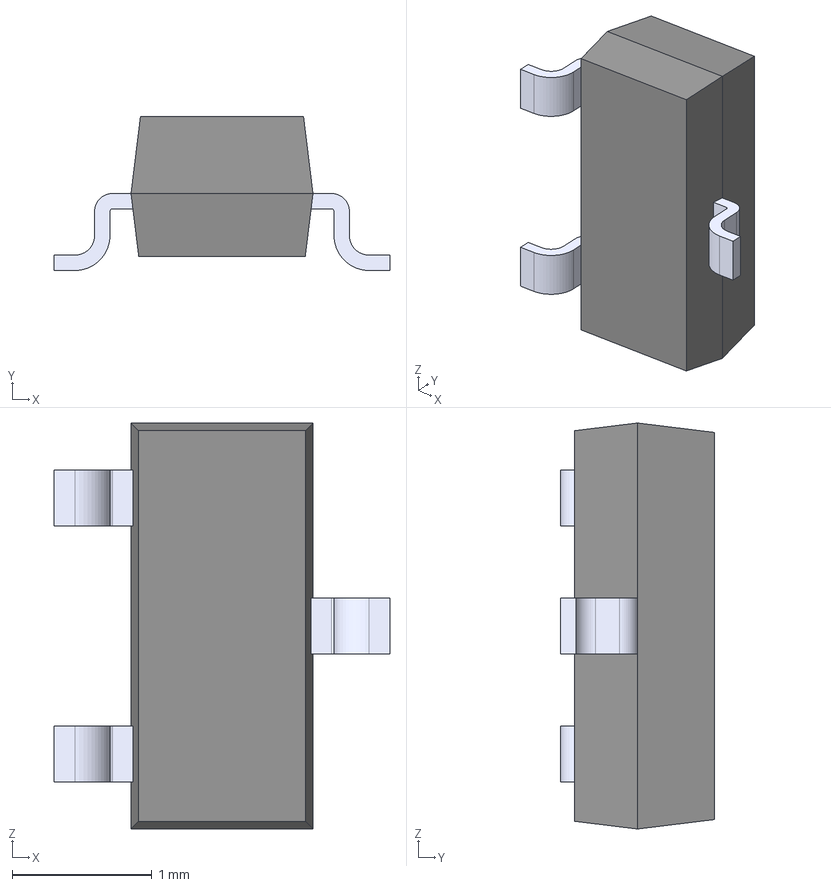
[picture p76: CAD file, 2024-10-02]
3D_models/BSS138-7-F.step
2.40 x 1.10 x 2.90 mm
BSS138-13-F
BSS138-13-F001
BSS138-13-F002
BSS138-13-F003
