ionutms/KiCad_Database_Library/3D_models/21-0087_C1441C_MXM.step

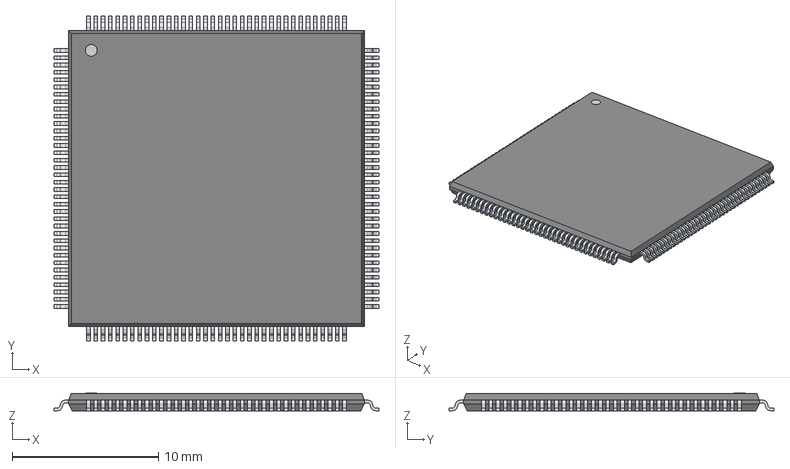
[picture p77: CAD file, 2024-10-02]
3D_models/21-0087_C1441C_MXM.step
22.2 x 22.2 x 1.20 mm
