ionutms/KiCad_Database_Library/3D_models/R_0402.step

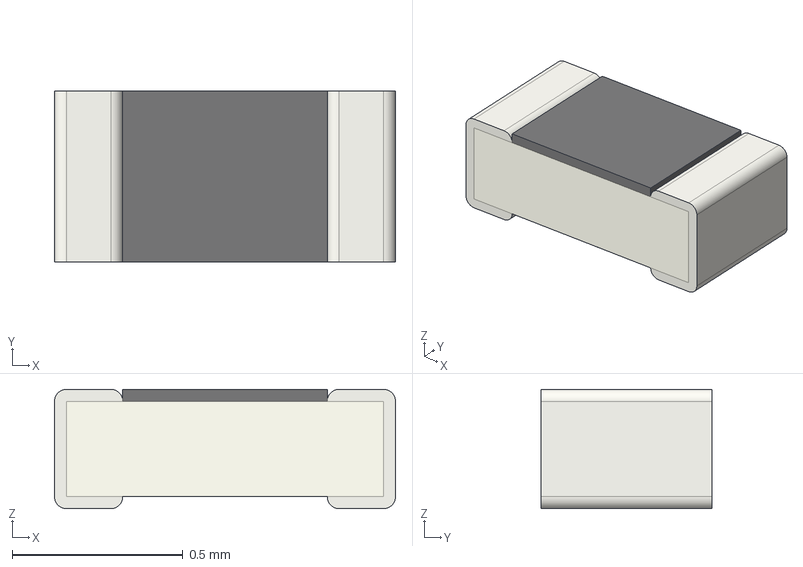
[picture p78: CAD file, 2024-10-02]
3D_models/R_0402.step
1.00 x 0.5 x 0.35 mm
