ionutms/KiCad_Database_Library/3D_models/C_0805.step

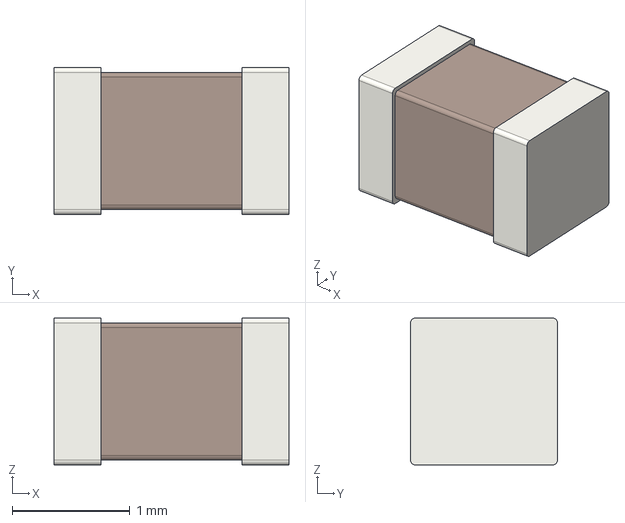
[picture p79: CAD file, 2024-10-02]
3D_models/C_0805.step
2.00 x 1.25 x 1.25 mm
