ionutms/KiCad_Database_Library/3D_models/C_0603.step

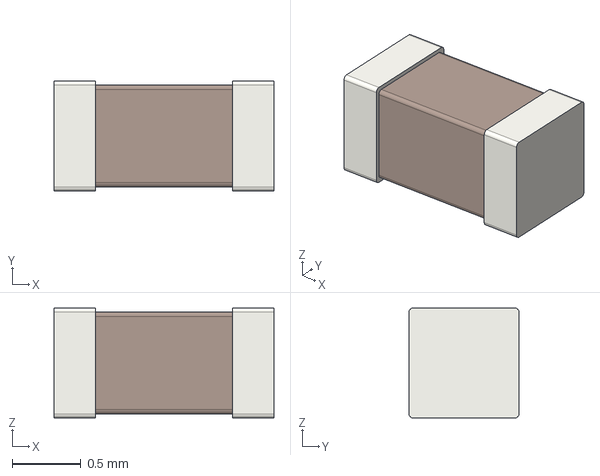
[picture p80: CAD file, 2024-10-02]
3D_models/C_0603.step
1.60 x 0.8 x 0.8 mm
