ionutms/KiCad_Database_Library/3D_models/21-0056C_20_MXM.step

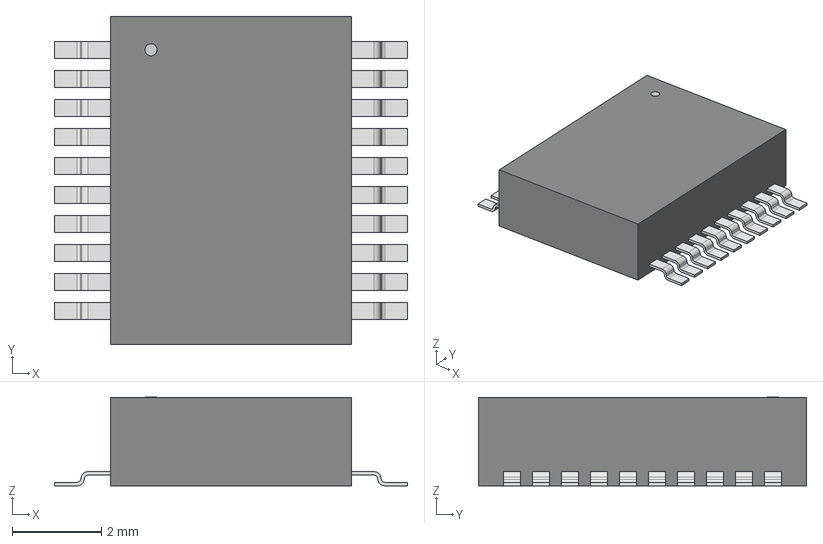
[picture p81: CAD file, 2024-10-02]
3D_models/21-0056C_20_MXM.step
7.90 x 7.34 x 1.98 mm
