ionutms/KiCad_Database_Library/3D_models/FA-128.stp

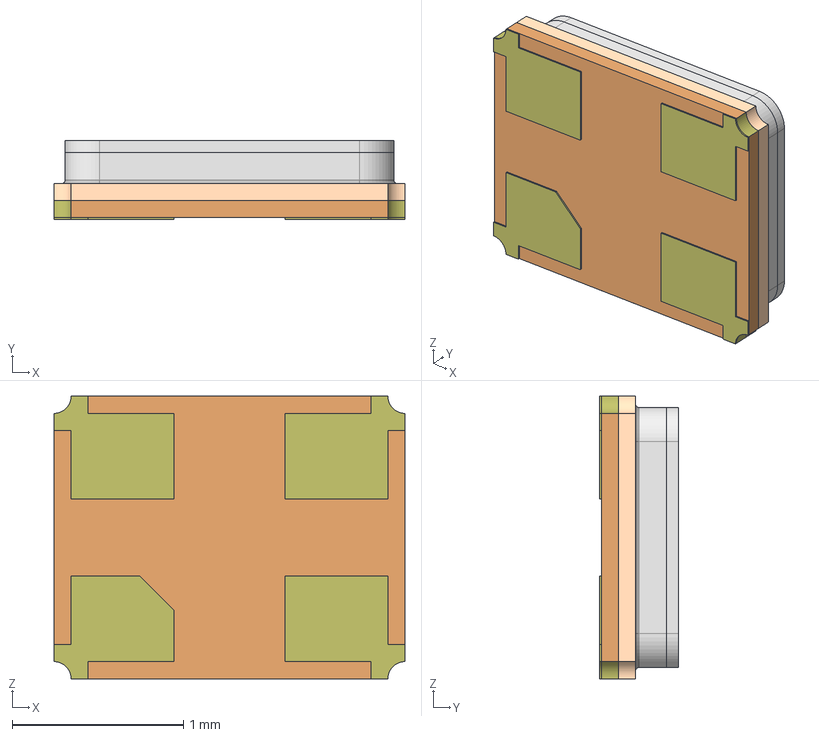
[picture p82: CAD file, 2024-10-02]
3D_models/FA-128.stp
2.05 x 0.46 x 1.65 mm
FA-128_Lidt
FA-128_Lidt001
FA-128_Lidt002
FA-128_Lidt003
FA-128_Lidt004
FA-128_Lidt005
FA-128_Lidt006
