ionutms/KiCad_Database_Library/3D_models/LED_0402.step

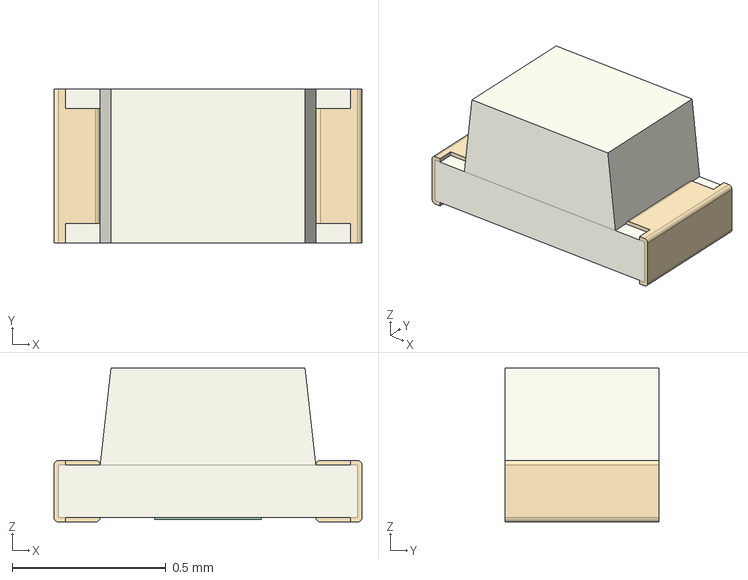
[picture p83: CAD file, 2024-10-02]
3D_models/LED_0402.step
1.00 x 0.5 x 0.5 mm
