ionutms/KiCad_Database_Library/3D_models/21-0664_TD12331C_MXM.step

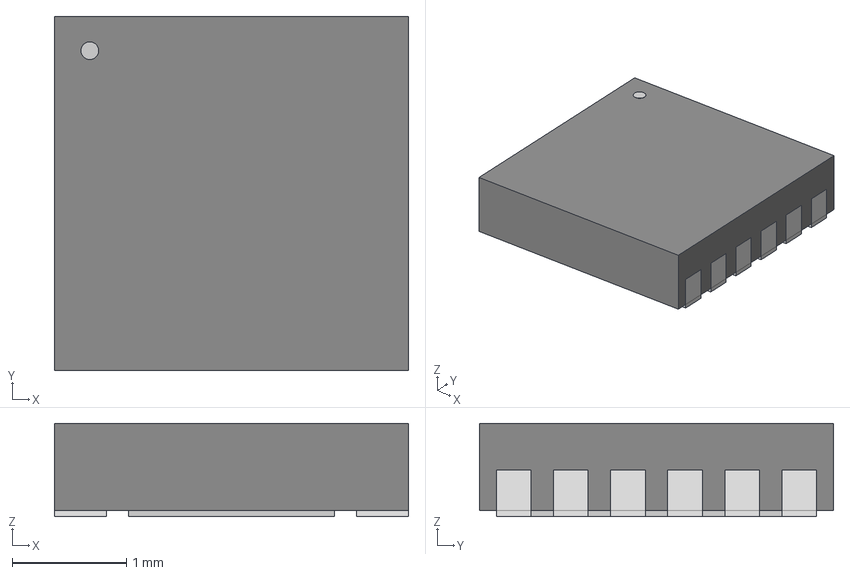
[picture p84: CAD file, 2024-10-02]
3D_models/21-0664_TD12331C_MXM.step
3.10 x 3.10 x 0.815 mm
