ionutms/KiCad_Database_Library/3D_models/CUI_DEVICES_TBP02R2-381-02BE.step

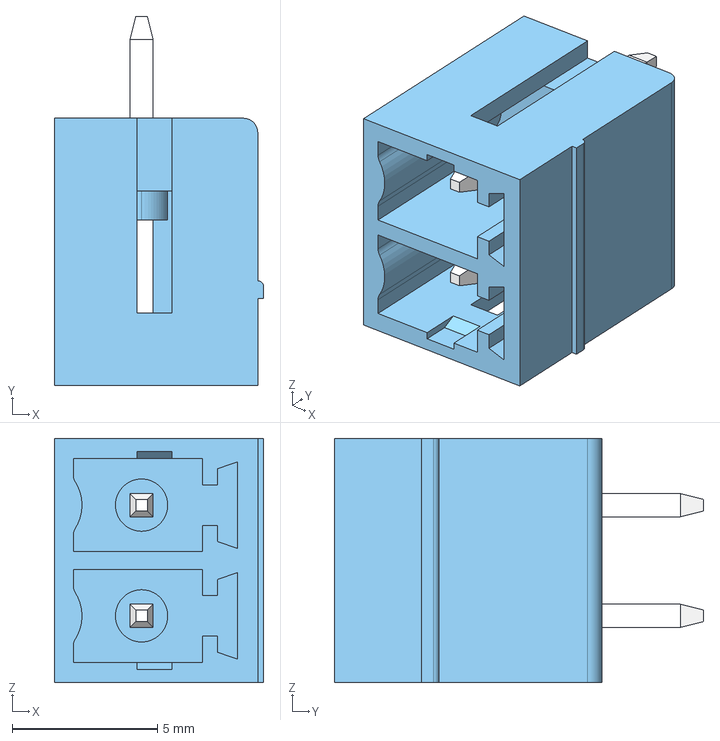
[picture p85: CAD file, 2024-10-02]
3D_models/CUI_DEVICES_TBP02R2-381-02BE.step
7.20 x 12.7 x 8.41 mm
