ionutms/KiCad_Database_Library/3D_models/SOP8_200MIL_MAC.step

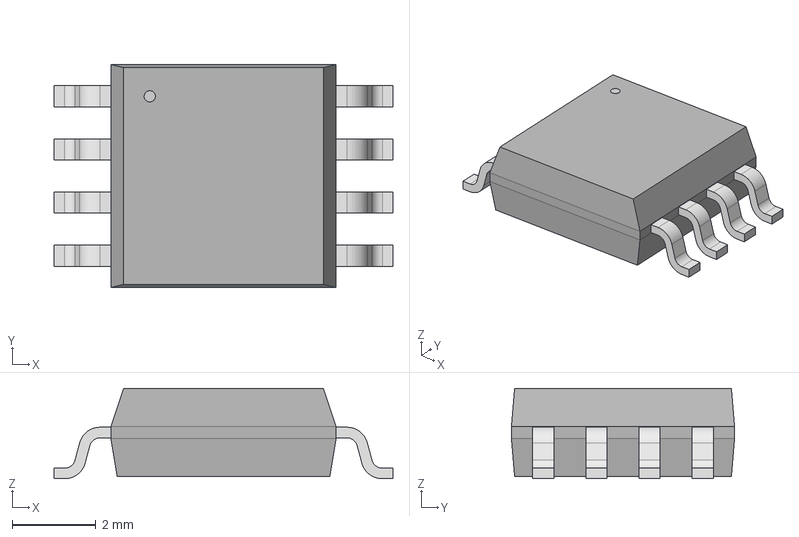
[picture p86: CAD file, 2024-10-02]
3D_models/SOP8_200MIL_MAC.step
8.10 x 5.33 x 2.16 mm
