ionutms/KiCad_Database_Library/3D_models/PowerPAK_1212-8.step

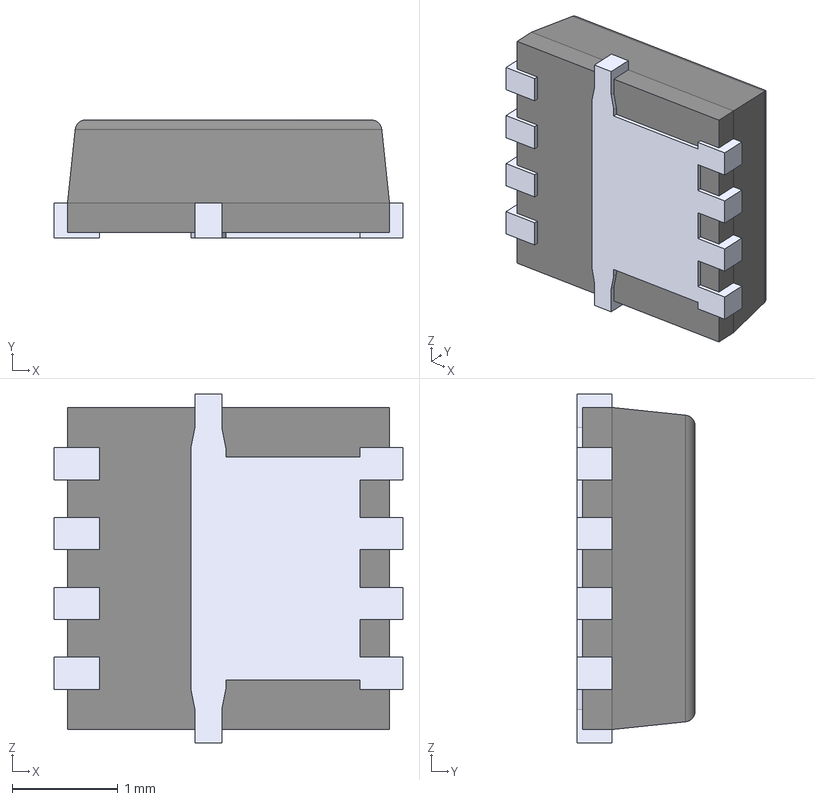
[picture p87: CAD file, 2024-10-02]
3D_models/PowerPAK_1212-8.step
3.30 x 1.12 x 3.30 mm
SIS468DN-T1-GE3
SIS468DN-T1-GE004
SIS468DN-T1-GE005
SIS468DN-T1-GE006
SIS468DN-T1-GE007
SIS468DN-T1-GE008
