ionutms/KiCad_Database_Library/3D_models/C_1206.step

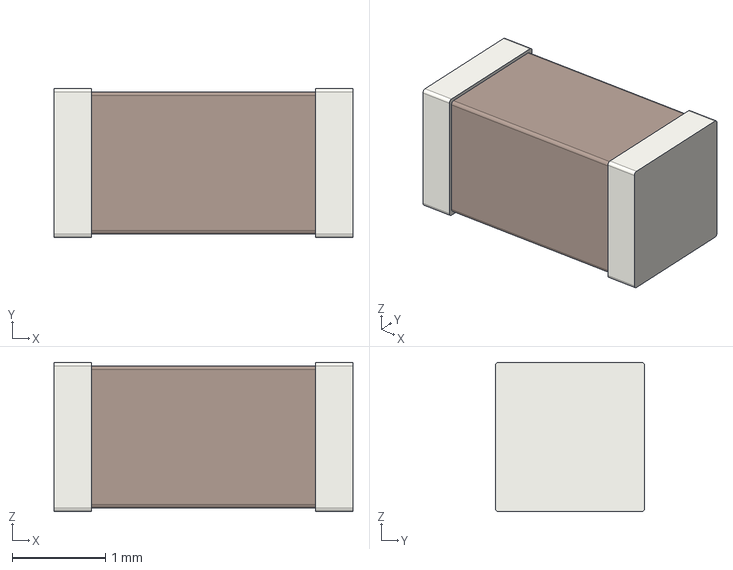
[picture p88: CAD file, 2024-10-02]
3D_models/C_1206.step
3.20 x 1.60 x 1.60 mm
