ionutms/KiCad_Database_Library/3D_models/CUI_DEVICES_TBP02R2-381-03BE.step

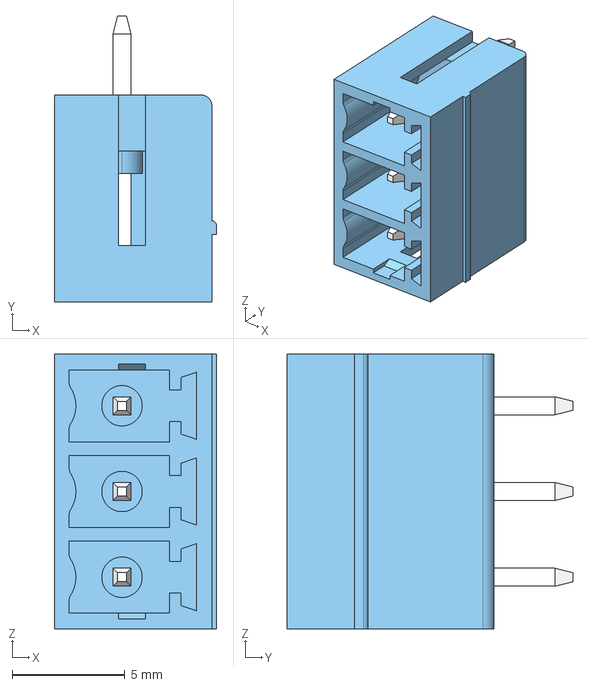
[picture p89: CAD file, 2024-10-02]
3D_models/CUI_DEVICES_TBP02R2-381-03BE.step
7.20 x 12.7 x 12.2 mm
