ionutms/KiCad_Database_Library/3D_models/21-0041B_8_MXM.step

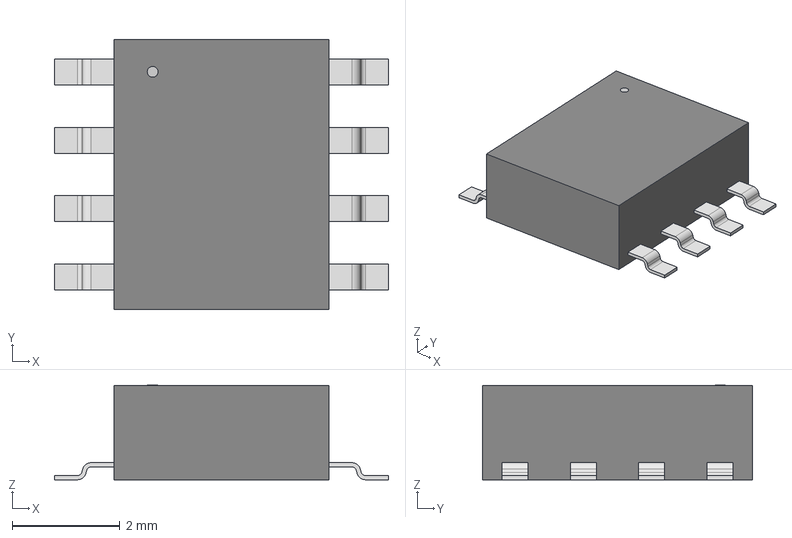
[picture p90: CAD file, 2024-10-02]
3D_models/21-0041B_8_MXM.step
6.20 x 5.00 x 1.75 mm
