ionutms/KiCad_Database_Library/3D_models/CP-41-1_ADI.step

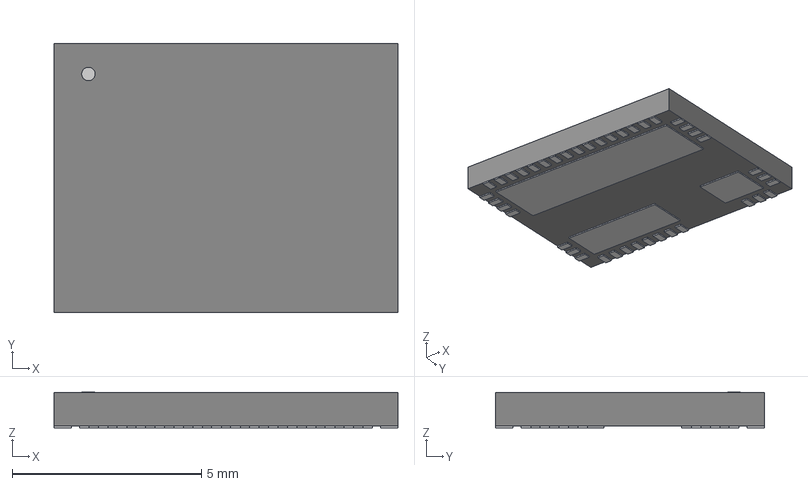
[picture p91: CAD file, 2024-10-02]
3D_models/CP-41-1_ADI.step
9.09 x 7.11 x 0.942 mm
