ionutms/KiCad_Database_Library/3D_models/FTSH-105-01-L-DV-K.step

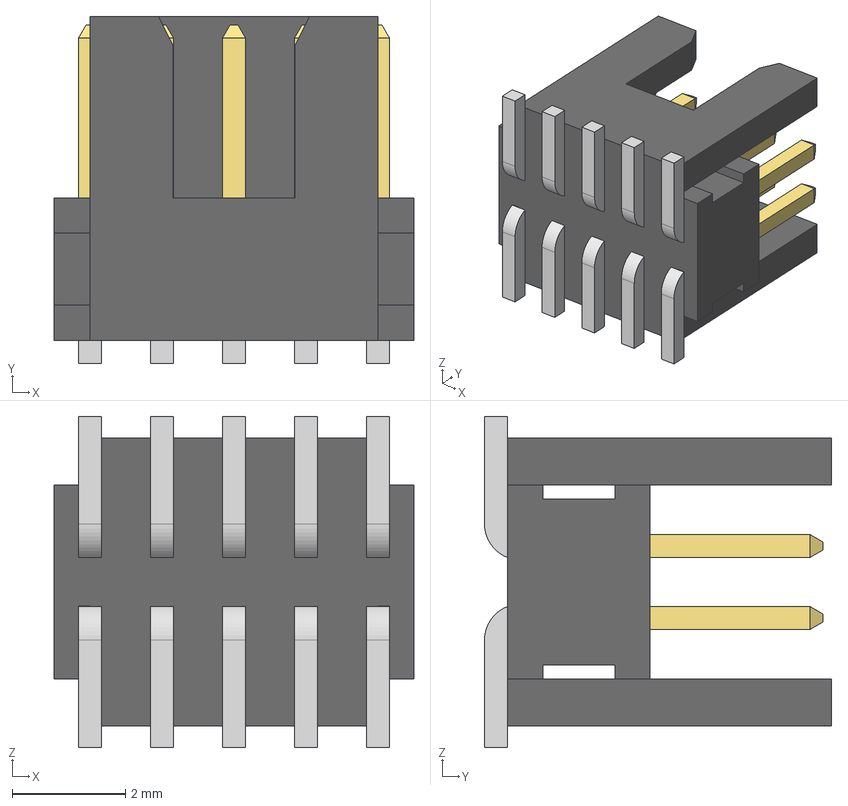
[picture p92: CAD file, 2024-10-02]
3D_models/FTSH-105-01-L-DV-K.step
6.35 x 6.12 x 5.84 mm
FTSH-105-01-L-DV-K_body
FTSH-105-01-L-DV-K_pins1
FTSH-105-01-L-DV-K_pins2
