ionutms/KiCad_Database_Library/3D_models/CP-64-15_ADI.step

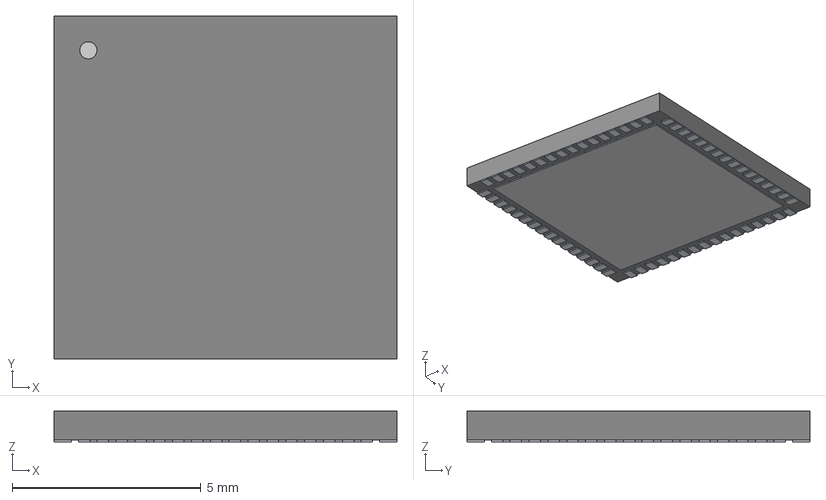
[picture p93: CAD file, 2024-10-02]
3D_models/CP-64-15_ADI.step
9.09 x 9.09 x 0.815 mm
