ionutms/KiCad_Database_Library/3D_models/21-0144H_T4877-6.step

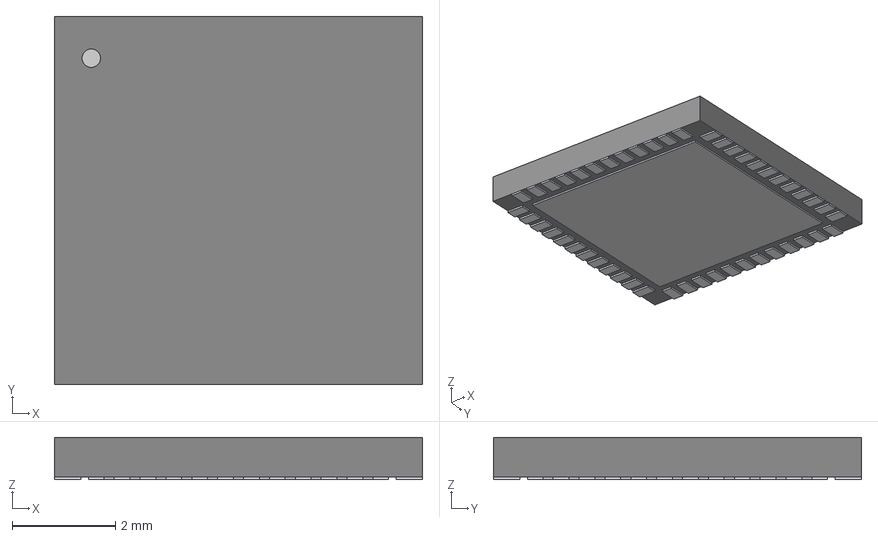
[picture p94: CAD file, 2024-10-02]
3D_models/21-0144H_T4877-6.step
7.11 x 7.11 x 0.815 mm
