ionutms/KiCad_Database_Library/3D_models/05-08-1695_ADI.step

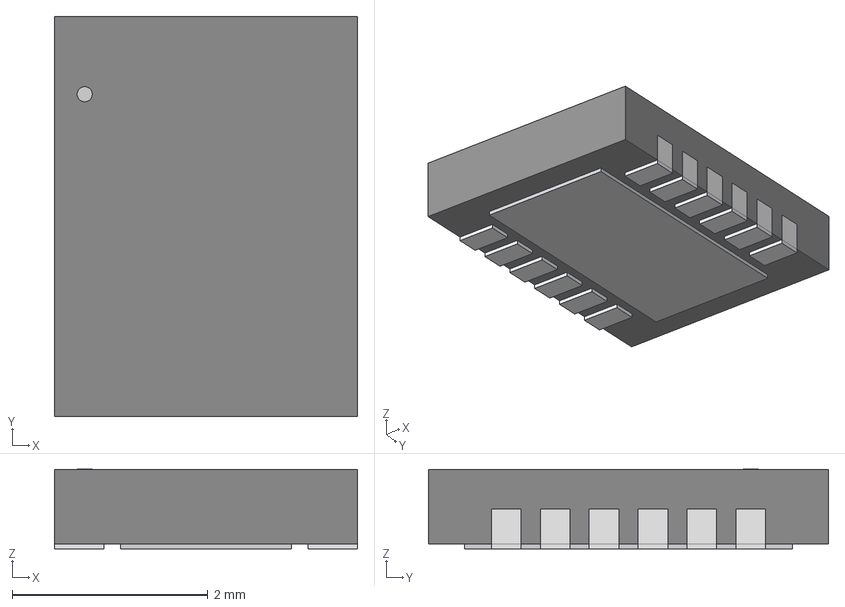
[picture p95: CAD file, 2024-10-02]
3D_models/05-08-1695_ADI.step
3.10 x 4.09 x 0.815 mm
