ionutms/KiCad_Database_Library/3D_models/RM_8_ADI.step

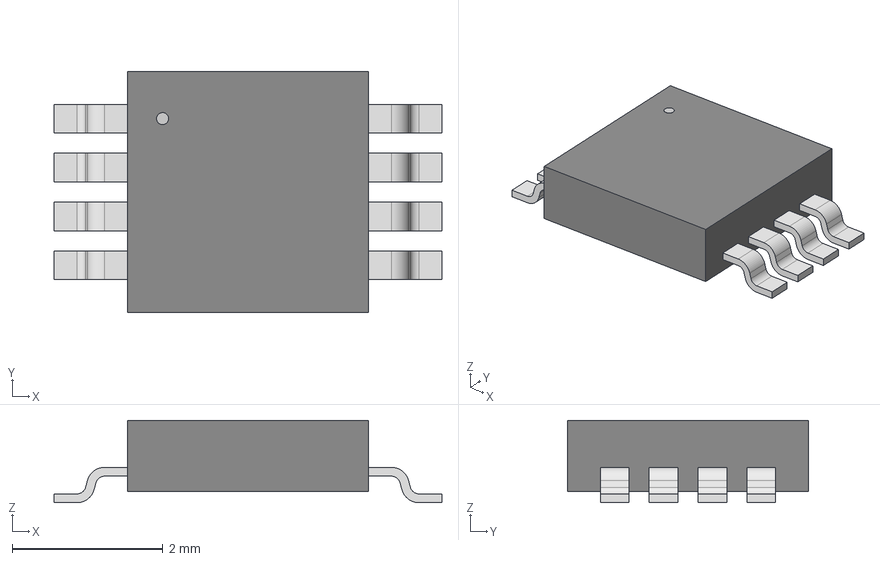
[picture p97: CAD file, 2024-10-02]
3D_models/RM_8_ADI.step
5.16 x 3.20 x 1.09 mm
