ionutms/KiCad_Database_Library/3D_models/21-0041_S161_MXM.step

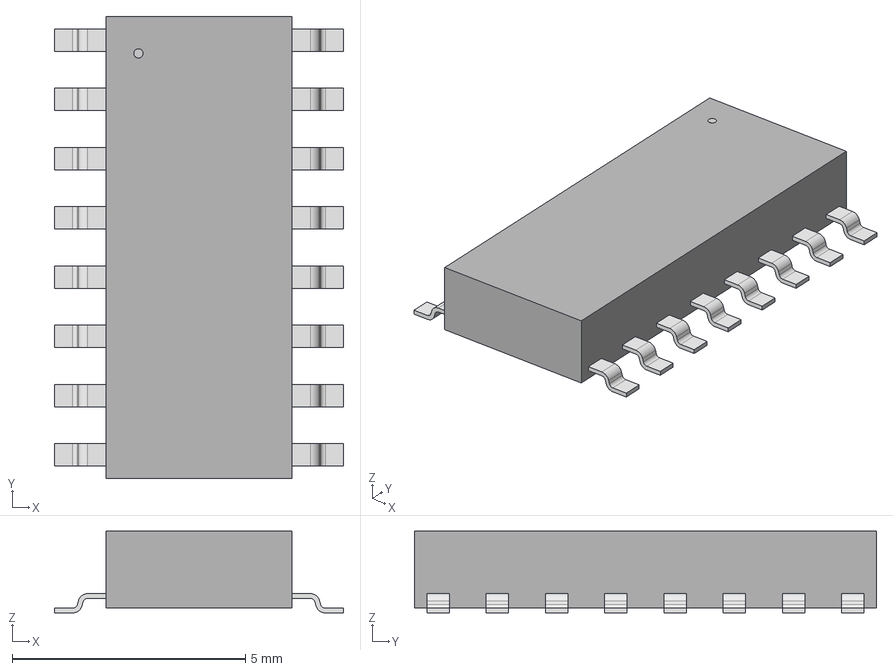
[picture p98: CAD file, 2024-10-02]
3D_models/21-0041_S161_MXM.step
6.20 x 9.91 x 1.75 mm
