ionutms/KiCad_Database_Library/3D_models/CP-40-29_ADI.step

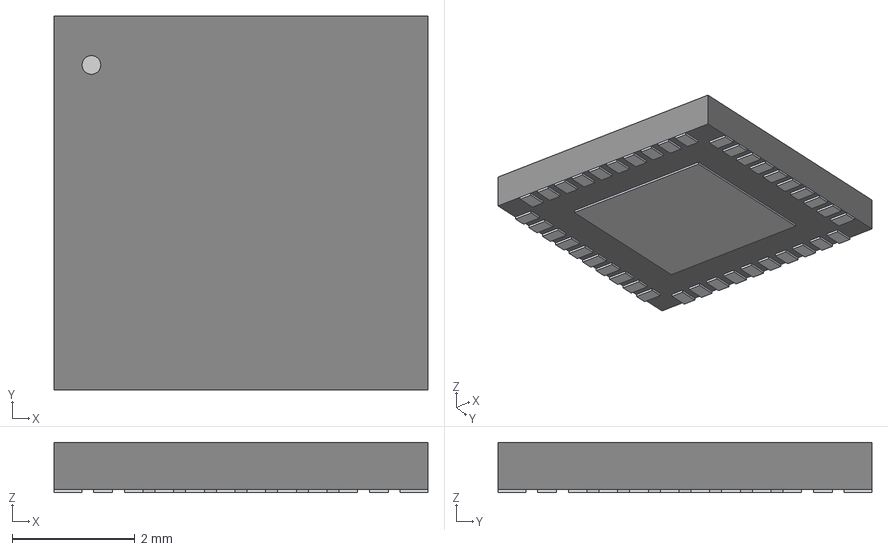
[picture p99: CAD file, 2024-10-02]
3D_models/CP-40-29_ADI.step
6.10 x 6.10 x 0.815 mm
