ionutms/KiCad_Database_Library/3D_models/SSW-106-01-T-D.stp

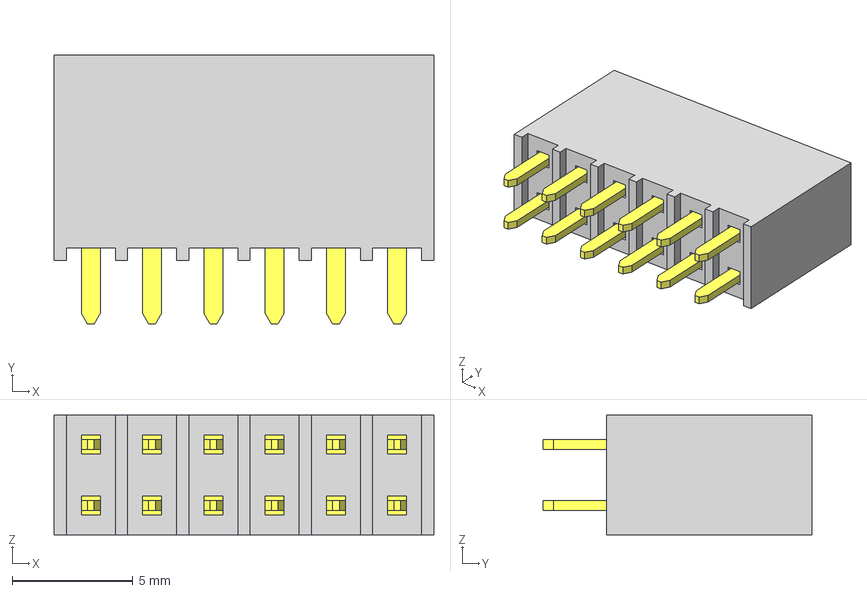
[picture p100: CAD file, 2024-10-02]
3D_models/SSW-106-01-T-D.stp
15.7 x 11.2 x 4.95 mm
T1SSW-106-01-T-D
P2SSW-106-01-T-D
