ionutms/KiCad_Database_Library/3D_models/CUI_DEVICES_TBP02R2-381-08BE.step

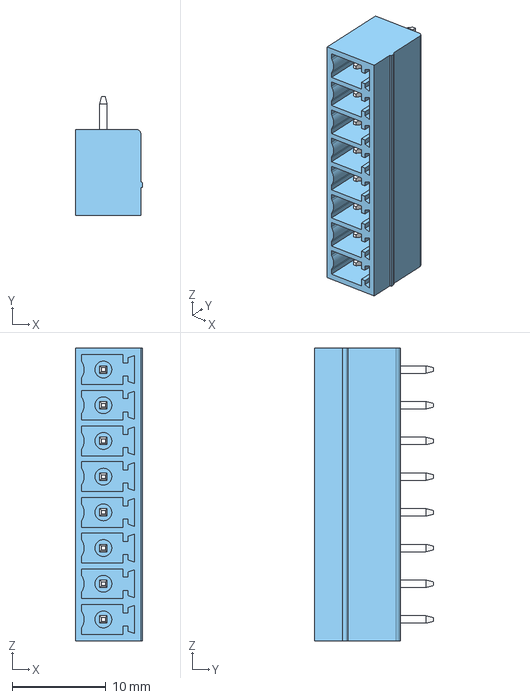
[picture p101: CAD file, 2024-10-02]
3D_models/CUI_DEVICES_TBP02R2-381-08BE.step
7.20 x 12.7 x 31.3 mm
