ionutms/KiCad_Database_Library/(list of files, cad)

Other CAD files:
3D_models/XFL6060.step
3D_models/XFL5030.step
3D_models/XFL5015.step
3D_models/XFL4030.step
3D_models/XFL4020.step
3D_models/C_0402.step
3D_models/2907525__UM108_Profil.step
3D_models/2959683__UM108_SEFE_R.step
3D_models/2959696__UM108_SEFE_L.step
