ionutms/KiCad_Database_Library/(commit log)

2024-09-15 add footprints
2024-09-15 add 3D models
    [2907525__UM108_Profil.step, 2959683__UM108_SEFE_R.step, 2959696__UM108_SEFE_L.step]
2024-09-15 add MAX32650GCE+
    [21-0087_C1441C_MXM.step]
2024-09-16 add ADIN1110CCPZ
    [CP-40-29_ADI.step]
2024-09-16 add LTC9111RDE-PBF
    [05-08-1695_ADI.step]
2024-09-16 add MAX14906ATM+
    [21-0144H_T4877-6.step]
2024-09-16 add AD74413RBCPZ
    [CP-64-15_ADI.step]
2024-09-16 add MAX14483AAP+
    [21-0056C_20_MXM.step]
2024-09-16 add MAX14933ASE+
    [21-0041_S161_MXM.step]
2024-09-16 add MAX12930EASA+
    [21-0041B_8_MXM.step]
2024-09-16 add ADP1032ACPZ-5-R7
    [CP-41-1_ADI.step]
2024-09-16 add TBP02R2-381-02BE
    [CUI_DEVICES_TBP02R2-381-02BE.step]
2024-09-16 add TBP02R2-381-08BE
    [CUI_DEVICES_TBP02R2-381-08BE.step]
2024-09-16 add TBP02R2-381-03BE
    [CUI_DEVICES_TBP02R2-381-03BE.step]
2024-09-16 add TBP04R2-500-02BE
    [CUI_DEVICES_TBP04R2-500-02BE.step]
2024-09-17 add S80KS5122GABHM020
    [PG-BGA-24-801.step]
2024-09-17 minor pin swaping for MAX32650GCE+ symbol
2024-09-23 add 3D model for 21-0041_S16&plus_1_MXM
    [21-0041_S161_MXM.step]
2024-09-23 update 21-0041_S161_MXM
    [21-0041_S161_MXM.step]
2024-09-23 add MX25U6432FM2I02
    [SOP8_200MIL_MAC.step]
2024-09-23 update footprint path
2024-09-23 add ADT75BRMZ
    [RM_8_ADI.step]
2024-09-23 add PSMN075-100MSEX
    [PSMN075-100MSEX.STEP]
2024-10-02 Switched from Git LFS to regular Git files
2024-10-02 add the latest 3D models
    [05-08-1695_ADI.step, 21-0041B_8_MXM.step, 21-0041_S161_MXM.step, 21-0056C_20_MXM.step, 21-0087_C1441C_MXM.step, 21-0144H_T4877-6.step, 21-0664_TD12331C_MXM.step, 2907525__UM108_Profil.step]
2024-10-02 add the latest footprints
2024-10-02 add ZA9644-AED
    [ZA9644-AED.step]
2024-10-02 add XFL3012-104MEC
    [XFL3012.step]
2024-10-02 add US1DWF-7
    [SOD123F.step]
2024-10-02 add solder jumpers lib
2024-10-02 add GCM32DC72A475KE02L
    [C_1210.step]
2024-10-02 add c1210
    [C_1210_3225Metric.step]
2024-10-02 add DFLS1200Q-7
    [PowerDI-123.step]
2024-10-02 add MMSZ5265BT1G
    [SOD-123.step]
2024-10-02 add XAL5050-223MEC
    [XAL5050.step]
2024-10-02 update footprint "XAL5050"
2024-10-03 add SRF0905A-471Y
    [SRF0905A.step]
2024-10-03 add ADP225ACPZ-R7
    [CP_8_10_ADI.step]
2024-10-04 add 2 pad solder jumper
2024-10-04 update SolderJumper_2_Bridged
2024-10-04 add MSD1048H-683MED
    [MSD1048H.step]
2024-10-04 add PMEG10020AELR
    [SOD123W.step]
2024-10-04 add PTVS58VP1UTP,115
    [SOD128.step]
2024-10-04 add ERJ-6ENF40R2V
    [R_0805.step]
2024-10-04 add BUK9K29-100E
    [SOT1205.step]
2024-10-04 add BSS138-7-F
    [SOT-323.step]
2024-10-05 add C1812C101JHGACTU
    [C_1812.step]
2024-10-05 add CHV2010-JW-475ELF
    [R_2010.step]
2024-10-05 add 742792731
    [L_0402.step]
2024-10-05 add ZXMP6A17E6TA
    [SOT-26.step]
2024-10-05 add SBAV99WT1G
    [SC-70.step]
2024-10-07 add SMCJ40CA-TR
    [SMCJ40CA.step]
2024-10-08 add KiCAD_Symbol_Generator submodule
2024-10-17 update testpoint footprint
2024-10-23 add R_1206 footprint and 3D model
    [R_1206.step]
2024-10-25 update footprint "R_0402_1005Metric"
2024-10-25 update footprint "R_0603_1608Metric"
2024-10-25 update footprint "R_0805_2012Metric"
2024-10-25 update footprint "R_1206_3216Metric"
2024-10-25 update footprint "R_2010_5025Metric"
2024-10-25 update footprint "C_0603_1608Metric"
2024-10-25 update footprint "C_0805_2012Metric"
2024-10-25 update footprint "C_1206_3216Metric"
2024-10-25 update footprint "C_1210_3225Metric"
2024-10-25 update footprint "C_1812_4532Metric"
2024-10-27 update footprint "XFL3012"
2024-10-27 add footprint "XFL3010"
2024-10-28 update xfl3010
    [XFL3010.step]
2024-10-28 update xfl3012
    [XFL3012.step]
2024-10-28 add xfl4012
    [XFL4012.step]
2024-10-28 add xfl4015
    [XFL4015.step]
2024-10-28 add xfl4020
    [XFL4020.step]
2024-10-28 add xfl4030
    [XFL4030.step]
2024-10-28 update footprints
2024-10-28 add xfl5015
    [XFL5015.step]
2024-10-28 add xfl5018
    [XFL5018.step]
2024-10-28 add xfl5030
    [XFL5030.step]
2024-10-28 add xfl6012
    [XFL6012.step]
2024-10-28 add xfl6060
    [XFL6060.step]
2024-10-28 add xfl7015
    [XFL7015.step]
2024-10-30 add xfl2010
    [XFL2010.step]
2024-10-30 add xfl2006
    [XFL2006.step]
2024-10-30 add xfl2005
    [XFL2005.step]
2024-10-30 add xal4020
    [XAL4020.step]
2024-10-30 add xal4030
    [XAL4030.step]
2024-10-30 add xal4040
    [XAL4040.step]
2024-10-30 add xal5020
    [XAL5020.step]
2024-10-30 add xal5030
    [XAL5030.step]
2024-10-30 update xal5050
    [XAL5050.step]
2024-10-30 add xal6020
    [XAL6020.step]
2024-10-30 add xal6030
    [XAL6030.step]
2024-10-30 add xal6060
    [XAL6060.step]
2024-10-30 add xal7020
    [XAL7020.step]
2024-10-31 add xal1030
    [XAL1030.step]
2024-10-31 add xal1060
    [XAL1060.step]
2024-10-31 add xal1080
    [XAL1080.step]
2024-10-31 add xal7030
    [XAL7030.step]
2024-10-31 add xal7050
    [XAL7050.step]
2024-10-31 add xal7070
    [XAL7070.step]
2024-10-31 add xal8050
    [XAL8050.step]
2024-10-31 add xal8080
    [XAL8080.step]
2024-11-01 add xal1010
    [XAL1010.step]
2024-11-01 add xal1350
    [XAL1350.step]
2024-11-01 add xal1510
    [XAL1510.step]
2024-11-01 add xal1513
    [XAL1513.step]
2024-11-01 add xal1580
    [XAL1580.step]
2024-11-03 add footprint TBP02R2-381-02BE
2024-11-03 add footprint TBP02R2-381-03BE
2024-11-03 update footprint TBP02R2-381-03BE
2024-11-03 add TBP02R2-381-04BE
    [CUI_DEVICES_TBP02R2-381-04BE.step]
2024-11-03 add TBP02R2-381-05BE
    [CUI_DEVICES_TBP02R2-381-05BE.step]
2024-11-03 add TBP02R2-381-06BE
    [CUI_DEVICES_TBP02R2-381-06BE.step]
2024-11-03 add TBP02R2-381-07BE
    [CUI_DEVICES_TBP02R2-381-07BE.step]
2024-11-04 add footprint "TBP02R2-381-08BE"
2024-11-04 add TBP02R2-381-09BE
    [CUI_DEVICES_TBP02R2-381-09BE.step]
2024-11-04 add TBP02R2-381-10BE
    [CUI_DEVICES_TBP02R2-381-10BE.step]
2024-11-04 add TBP02R2-381-12BE
    [CUI_DEVICES_TBP02R2-381-12BE.step]
2024-11-04 add TBP02R2-381-14BE
    [CUI_DEVICES_TBP02R2-381-14BE.step]
2024-11-04 add TBP02R2-381-16BE
    [CUI_DEVICES_TBP02R2-381-16BE.step]
2024-11-04 update footprint "TBP04R2-500-02BE"
2024-11-04 add TBP04R2-500-03BE
    [CUI_DEVICES_TBP04R2-500-03BE.step]
2024-11-04 add TBP04R2-500-04BE
    [CUI_DEVICES_TBP04R2-500-04BE.step]
2024-11-04 add TBP04R2-500-05BE
    [CUI_DEVICES_TBP04R2-500-05BE.step]
2024-11-04 add add TBP04R2-500-06BE
    [CUI_DEVICES_TBP04R2-500-06BE.step]
2024-11-04 add add TBP04R2-500-07BE
    [CUI_DEVICES_TBP04R2-500-07BE.step]
2024-11-04 add TBP04R2-500-08BE
    [CUI_DEVICES_TBP04R2-500-08BE.step]
2024-11-04 add TBP04R2-500-09BE
    [CUI_DEVICES_TBP04R2-500-09BE.step]
2024-11-04 add TBP04R2-500-10BE
    [CUI_DEVICES_TBP04R2-500-10BE.step]
2024-11-04 add TBP04R2-500-11BE
    [CUI_DEVICES_TBP04R2-500-11BE.step]
2024-11-04 add TBP04R2-500-12BE
    [CUI_DEVICES_TBP04R2-500-12BE.step]
2024-11-12 add a castelated "pin"
2024-11-12 update castelated "pin"
